Chen-long-bo/-/车轮布局.jpg

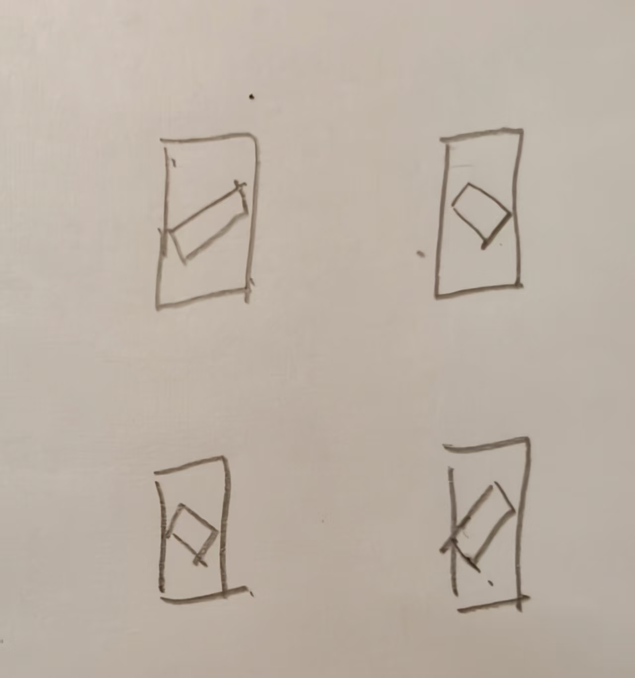
车轮布局.jpg
