Chen-long-bo/-/README.md

# 蓝牙遥控麦轮小车

第一版小车底盘。

## 文档导航

- [教学手册](教学手册.md) —— 从零理解系统、协议、算法、参数和标定流程
- [Keil 使用导航](Keil使用导航.md) —— 打开工程、编译、烧录、调试
- [参数手册](参数手册.md) —— 每个参数的作用、范围、测法和调错现象
- [代码地图](代码地图.md) —— 每个文件所在层、作用、必要性和关键函数
- [工程只读分析报告](工程只读分析报告.md) —— 数据流、参数清单、待确认项、最小改动清单
- [接线图说明](01_接线图.md) / [引脚分配表](02_引脚分配表.md) / [通信协议](03_通信协议_v0.1.md)
- [可视化网站](visualization/index.html) —— 手机适配的离线教学台、标定向导、运动学和 PID 实验
- [分享文件](分享文件/使用说明.txt) —— 单文件网站、单文件手册和完整离线分享包
- [本次修改说明（2026-10-21）](本次修改说明_2026-10-21.md) —— 按键遥控、PID 分离、参数页、缓起缓停删除和烧录结果
- [改造方案与阶段进度](改造方案大纲_v1.md)

## 目录

- `STM32_Project/`：STM32 主固件工程
- `Test_Project/`：编码器、单轮、CPR、旋转、PID 等测试工程
- `PC_上位机/`：PySide6 上位机
- `diagrams/`：系统架构、数据流、麦轮、协议、PID 等 SVG 示意图
