Chen-long-bo/-/03_通信协议_v0.1.md

# 03 蓝牙通信协议 v0.2（PC ↔ STM32）

> 本协议用于 PC 上位机 ↔ HC-04（经典蓝牙 SPP）↔ STM32。
> 2026-10-21 起：普通控制不使用 PID，缓起/缓停/加速度平滑指令已删除；PID 只用于控制与测试页的位置控制。

## 1. 帧格式（小端 little-endian）

```text
[SOF 0xAA][SOF 0x55][LEN][CMD][DATA...][CHECK]
```

| 字段 | 字节数 | 说明 |
|---|---:|---|
| SOF | 2 | 固定 `AA 55` |
| LEN | 1 | `CMD + DATA` 的总字节数，最小 1 |
| CMD | 1 | 指令码 |
| DATA | LEN-1 | 参数数据 |
| CHECK | 1 | `(LEN + CMD + 所有DATA) & 0xFF` |

示例：心跳

```text
AA 55 01 0A 0B
```

LEN=0x01，CHECK=0x01+0x0A=0x0B。

## 2. PC → STM32 指令

| CMD | 名称 | DATA | 说明 |
|---|---|---|---|
| 0x01 | 手动全向速度 | vx(int16) vy(int16) wz(int16) | 单位 0.001 m/s、0.001 rad/s；普通手动页使用，不使用 PID |
| 0x02 | 急刹停 | 无 | 立即发零速度 |
| 0x04 | PID 位置控制 | target(int16) | 目标相对距离，单位 mm；只有控制与测试页使用 |
| 0x05 | 固定路线 | route_id(uint8) side(uint8) | 当前为固件路线占位接口，PC 路线也可在 PC 端执行 |
| 0x06 | 急停 | 无 | 立即停车并清目标 |
| 0x07 | 预留速度环 PID | 无 | 速度环在驱动模块内部，当前不使用 |
| 0x08 | 设置位置 PID | Kp(uint16) Ki(uint16) Kd(uint16) | 参数×1000，只影响位置控制 |
| 0x09 | 清编码器零点 | 无 | 记录当前累计计数为零点 |
| 0x0A | 心跳 | 无 | STM32 回复 ACK 0x83 |
| 0x0B | 读取参数 | 无 | 回复参数帧 0x85 |
| 0x0C | 设置限幅 | vmax(uint16) wmax(uint16) | 单位 0.001 m/s、0.001 rad/s |
| 0x0D | 原地旋转 | angle(int16) | 单位 0.1°；正数左转，负数右转；时间控制，不使用 PID |
| 0x20~0x2F | 自动驾驶预留 | 后续定义 | 预留 |
| 0x30~0x3F | 避障预留 | 后续定义 | 预留 |
| 0x40~0x4F | 视觉预留 | 后续定义 | 预留 |

> 0x03（缓停）和 0x0E（设置加速度）已在 2026-10-21 版本删除。

## 3. STM32 → PC 回报

| CMD | 名称 | DATA | 说明 |
|---|---|---|---|
| 0x81 | 状态帧 | mode(uint8) battery_mV(uint16) enc1..4(int32×4) speed1..4(int16×4) | mode：0空闲/1手动/3PID位置控制/4路线/5旋转；速度单位0.001 m/s |
| 0x82 | 曲线帧 | target1..4(int16×4) actual1..4(int16×4) | 四轮目标/实际速度 |
| 0x83 | ACK | ack_cmd(uint8) err(uint8) | 指令确认 |
| 0x84 | 日志 | ASCII | 调试文本 |
| 0x85 | 参数帧 | pos_Kp/Ki/Kd(uint16×3) + 预留6字节 + vmax(uint16) wmax(uint16) | 当前参数回读 |

## 4. 位置/误差计算

控制与测试页：

```text
平均计数 = 四轮相对起点计数的平均值
实际位置 = 平均计数 / CPR × π × 轮径
位置误差 = 目标位置 - 实际位置
```

PC 端可以用 0x81 状态帧中的四轮累计计数直接计算实际位置和误差，不需要额外协议。

## 5. 版本规则

- 本文件版本 `v0.2`；
- 修改协议时必须同步更新 `PC_上位机/protocol.py`、`PC_上位机/config.py` 和 STM32 `bsp_bluetooth.c`；
- 新增功能优先使用预留指令段，不破坏已有指令。
