Chen-long-bo/-/代码地图.md

> **2026-10-21 变更提示**：当前版本已删除普通控制中的缓起/缓停和加速度平滑；PID 仅保留在控制与测试页。本文部分“平滑/ramp”描述属于历史版本，以实际源码和 `本次修改说明_2026-10-21.md` 为准。

# 麦轮小车 — 代码地图（文件作用 / 必要性 / 技术 / 关键函数）

> 目标：让你知道“每个文件为什么存在、删掉会怎样、用了什么技术、关键函数在哪”。
> 配套图：`diagrams/system_architecture.svg`、`diagrams/data_flow.svg`、`diagrams/mindmap.svg`。

---

## 1. 怎么读这张地图

工程分 4 层：

```text
PC 上位机（PySide6）
  ↓ 蓝牙/串口协议
STM32 应用层（control_mode / route）
  ↓
STM32 算法层（chassis_control / pid / bsp_encoder）
  ↓
STM32 设备层（bsp_motor / bsp_bluetooth / driver_comm）
  ↓
驱动模块 / 电机 / 编码器
```

每个文件下面会写：

- **所在层**；
- **作用**；
- **必要性**（删掉会怎样）；
- **采用技术**；
- **关键函数**；
- **被谁调用 / 调用谁**。

---

## 2. 主固件用户层（`STM32_Project\User`）

| 文件 | 所在层 | 作用 | 必要性 | 采用技术 | 关键函数 |
|---|---|---|---|---|---|
| `config.h` | 配置层 | 所有可调参数集中入口 | 删掉后所有模块找不到参数 | C 宏定义 | `CFG_*` |
| `user_app.c` | 应用入口层 | 初始化模块、启动串口接收、主循环 | 删掉后没有初始化/主循环 | HAL UART 中断、回调 | `User_Init`、`User_Loop`、`HAL_UART_RxCpltCallback` |
| `user_app.h` | 应用入口层 | 声明入口函数 | 删掉后 main.c 无法调用 | C 头文件 | `User_Init`、`User_Loop` |
| `bsp_bluetooth.c` | 协议层 | AA55 帧解析/发送 | 删掉后 PC 无法控制/看不到遥测 | 状态机、校验和、UART | `Bluetooth_Init`、`Bluetooth_OnRxByte`、`Bluetooth_SendFrame` |
| `bsp_bluetooth.h` | 协议层 | 协议接口声明 | 删掉后编译失败 | C 头文件 | — |
| `control_mode.c` | 控制决策层 | 模式状态机、平滑、位置 PID、定时旋转、遥测 | 删掉后没有控制逻辑 | 状态机、PID、斜坡、协议组帧 | `ControlMode_Init`、`ControlMode_OnCommand`、`ControlMode_Poll`、`ControlMode_RunSpeedLoop` |
| `control_mode.h` | 控制决策层 | 模式枚举/接口 | 删掉后协议层无法调用 | C 枚举 | `ControlMode_t` |
| `chassis_control.c` | 运动学层 | 麦轮正/逆运动学 | 删掉后无法把车体速度变成四轮速度 | 线性代数/几何 | `Chassis_Inverse`、`Chassis_Forward` |
| `chassis_control.h` | 运动学层 | 运动学接口 | 删掉后编译失败 | C 头文件 | — |
| `bsp_motor.c` | 执行器层 | 四轮速度限幅并下发 | 删掉后无法驱动电机 | 限幅、UART 文本协议 | `Motor_Init`、`Motor_SetSpeed`、`Motor_Stop` |
| `bsp_motor.h` | 执行器层 | 电机接口 | 删掉后编译失败 | C 头文件 | — |
| `bsp_encoder.c` | 传感器层 | 计数→速度/距离、零点 | 删掉后没有反馈 | 编码器换算、软件零点 | `Encoder_Init`、`Encoder_GetCounts`、`Encoder_GetWheelSpeeds`、`Encoder_CountsToDistance` |
| `bsp_encoder.h` | 传感器层 | 编码器接口 | 删掉后编译失败 | C 头文件 | — |
| `driver_comm.c` | 驱动通信层 | 发 `$Car`/读编码器/读电压，解析文本回包 | 删掉后 STM32 与驱动模块无法通信 | UART、`sscanf`、字符串格式化 | `DriverComm_SendCar`、`DriverComm_OnRxByte`、`DriverComm_RequestEncoder20ms` |
| `driver_comm.h` | 驱动通信层 | 驱动模块数据结构/接口 | 删掉后编译失败 | C 结构体 | `DriverComm_Data_t` |
| `pid.c` | 算法层 | 位置式 PID | 删掉后位置停无法闭环 | PID 控制 | `PID_Init`、`PID_Compute`、`PID_Reset` |
| `pid.h` | 算法层 | PID 结构体/接口 | 删掉后编译失败 | C 结构体 | `PID_HandleTypeDef` |
| `route.c` | 路线层 | 固件路线接口（当前空实现） | 删掉后协议 0x05 无处理；当前 PC 路线不用它 | 状态机占位 | `Route_Start`、`Route_Poll` |
| `route.h` | 路线层 | 路线接口声明 | 删掉后编译失败 | C 头文件 | — |

---

## 3. 主固件 CubeMX 生成层

| 文件 | 作用 | 必要性 | 技术 | 关键函数 |
|---|---|---|---|---|
| `Core\Src\main.c` | HAL 初始化、168MHz 时钟、串口初始化、调用 `User_Init/User_Loop` | 删掉后程序没有入口 | HAL、RCC/PLL | `main`、`SystemClock_Config` |
| `Core\Src\usart.c` | USART1/2/3 初始化、GPIO、NVIC | 删掉后串口不能用 | HAL UART、GPIO AF | `MX_USART1_UART_Init` 等、`HAL_UART_MspInit` |
| `Core\Src\stm32f4xx_it.c` | USART1/2/3 中断入口 | 删掉后中断不触发 | NVIC、HAL IRQ | `USART1_IRQHandler`、`USART2_IRQHandler`、`USART3_IRQHandler` |
| `Core\Src\stm32f4xx_hal_msp.c` | HAL MSP 钩子 | 删掉后底层初始化缺失 | HAL | `HAL_MspInit` |
| `Core\Src\gpio.c` | GPIO 初始化（当前无额外） | 删掉后 GPIO 初始化缺失 | HAL GPIO | `MX_GPIO_Init` |
| `Core\Src\system_stm32f4xx.c` | CMSIS 系统初始化 | 删掉后系统启动异常 | CMSIS | `SystemInit` |
| `Core\Inc\*.h` | HAL/中断/串口声明 | 删掉后编译失败 | C 头文件 | — |
| `Drivers\` | ST HAL/CMSIS 库 | 删掉后 HAL 函数找不到 | ST 官方库 | — |
| `MDK-ARM\MecanumCar.uvprojx` | Keil 工程 | 删掉后无法编译 | Keil MDK | — |

---

## 4. 测试/调试工程（`Test_Project\MecanumTest`）

| 文件 | 作用 | 必要性 | 技术 | 关键函数 |
|---|---|---|---|---|
| `Test\test_app.c` | COM5 ASCII 命令解析 | 删掉后测试工程没有交互 | 文本协议、状态机 | `Test_Init`、`Test_Loop`、`Test_Parse`、`Test_OnRxByte` |
| `Test\debug_algo.c` | 纯算法：麦轮/CPR/旋转/平滑 | 删掉后标定命令无法计算 | 几何、比例换算 | `DebugAlgo_Mecanum`、`DebugAlgo_SuggestCpr`、`DebugAlgo_SuggestRotateMs`、`DebugAlgo_RampStep` |
| `Test\pid.c` | PID 仿真 | 删掉后 `pidstep` 无法运行 | PID | `PID_Compute` |
| `Test\driver_comm.c` | 驱动模块通信（复用） | 删掉后无法驱动/读编码器 | UART | `DriverComm_SendCar`、`DriverComm_OnRxByte` |
| `Test\chassis_control.c` | 麦轮运动学（复用） | 删掉后 `car` 无法解算 | 运动学 | `Chassis_Inverse` |
| `Test\bsp_encoder.c` | 编码器换算（复用） | 删掉后 `enc` 无法换算 | 编码器 | `Encoder_GetCounts` |
| `Test\config.h` | 测试工程参数 | 删掉后测试工程没有参数 | C 宏 | `CFG_*` |
| `Core\...` | 测试工程 HAL/串口初始化 | 删掉后测试工程无法运行 | HAL | `MX_USART*_UART_Init` |

---

## 5. PC 上位机（`PC_上位机`）

| 文件 | 作用 | 必要性 | 技术 | 关键函数/类 |
|---|---|---|---|---|
| `main.py` | 程序入口 | 删掉后无法启动 | PySide6 | `main` |
| `config.py` | 所有上位机参数 | 删掉后界面/协议找不到配置 | Python 常量 | `MAX_VX`、`PORT_*`、`CMD_*` |
| `protocol.py` | 帧打包/解析、指令构造 | 删掉后无法通信 | 二进制协议、`struct` | `build_frame`、`FrameParser`、`cmd_manual`、`parse_status` |
| `serial_worker.py` | 串口线程 | 删掉后无法收发 | QThread、pyserial | `SerialWorker.run`、`send_frame` |
| `demo_worker.py` | 无硬件演示 | 删掉后演示模式不可用 | QThread、模拟 | `DemoWorker._update` |
| `ui\main_window.py` | 主窗口/交互 | 删掉后没有界面 | PySide6 | `MainWindow._manual_tick`、`_route_*`、`_build_debug_tab` |
| `widgets\joystick.py` | 虚拟摇杆 | 删掉后没有摇杆 | QPainter/鼠标事件 | `Joystick._set_from_pos` |
| `widgets\curve_panel.py` | 实时曲线 | 删掉后没有曲线 | pyqtgraph | `CurvePanel.update_data` |

---

## 6. 核心算法文件详解

### 6.1 `control_mode.c`（控制决策核心）

- **模式**：IDLE、MANUAL、BRAKE_SOFT、POS_STOP、ROTATE_ANGLE、ROUTE；
- **`ControlMode_Poll`**：每 20ms 执行一次；请求编码器/电压；按模式执行；
- **`ControlMode_RunSpeedLoop`**：
  1. `Chassis_Inverse` 把 vx/vy/wz 变成四轮线速度；
  2. 除以 `CFG_MAX_WHEEL_SPEED_M_S` 归一化到 -1~1；
  3. 若最大轮速 < `CFG_MIN_DRIVE`，整体放大到最小驱动；
  4. `Motor_SetSpeed` 发给驱动模块；
  5. `Encoder_GetWheelSpeeds` 读取实际速度用于上报。
- **平滑**：`RampToward` 让目标速度按 `g_accel_v/g_accel_w` 逐步变化；
- **位置停**：`ControlMode_GetDistance` + `PID_Compute` + 速度环；
- **旋转**：时间控制，`CFG_ROTATE_MS_PER_90`；
- **遥测**：`ControlMode_SendStatus`/`SendCurve` 组 0x81/0x82 帧。

### 6.2 `chassis_control.c`（麦轮运动学）

- `Chassis_Inverse`：
  ```text
  A = vx - vy - (a+b)·wz
  B = vx + vy + (a+b)·wz
  C = vx + vy - (a+b)·wz
  D = vx - vy + (a+b)·wz
  ```
- `Chassis_Forward` 是反推，调试用；
- **必要性**：没有它，无法把“车体速度”变成“四个轮子的速度”。

### 6.3 `bsp_encoder.c`（编码器换算）

- `Encoder_SetZero`：记录四轮当前累计计数作为零点；
- `Encoder_GetCounts`：当前累计 - 零点；
- `Encoder_GetWheelSpeeds`：20ms 计数 → 圈数 → 周长 → m/s；
- `Encoder_CountsToDistance`：累计计数 → 米；
- **关键参数**：`CFG_ENCODER_CPR`、`CFG_WHEEL_DIAMETER_MM`。

### 6.4 `driver_comm.c`（驱动模块通信）

- `DriverComm_SendCar`：格式化 `$Car:w1,w2,w3,w4!`；
- `DriverComm_SetMotorType520`：`$MOTOR_4CH_SET:0!`；
- `DriverComm_SetMotorParam`：`$MOTOR_PARAM:8,11,56!`；
- `DriverComm_RequestEncoder20ms/Total`：读编码器；
- `DriverComm_OnRxByte`：按 `!` 结尾解析模块回包；
- **技术**：UART 文本协议、`sscanf`、自定义浮点格式化（避免 `%f`）。

### 6.5 `bsp_bluetooth.c`（PC↔STM32 协议）

- `Bluetooth_OnRxByte`：状态机找 `AA 55` → LEN → CMD → DATA → CHECK；
- 校验和：`LEN+CMD+DATA` 求和低 8 位；
- `Bluetooth_SendFrame`：组帧并发送到 USART1；`CFG_DEBUG_BRIDGE_ENABLE=1` 时同时发 USART3。

### 6.6 `pid.c`（PID）

- 位置式 PID：`P=Kp·e`、`I=Ki·∫e`、`D=Kd·de`；
- 积分限幅/输出限幅；
- **注意**：当前 `D` 项没有除 `dt`，参数单位与采样周期有关；调参时以实际现象为准。

### 6.7 `route.c`（固件路线）

- 当前是空实现，`Route_Poll` 返回 0；
- PC 上位机的固定路线不依赖它；
- 若要“脱机路线”，需要在这里实现状态机（前进/转向/计时）。

### 6.8 `test_app.c` + `debug_algo.c`（调试工程）

- `test_app.c`：ASCII 命令解析，直接调用驱动/算法；
- `debug_algo.c`：纯算法，不碰硬件，方便单独验证；
- 新增命令：`mecanum/geo/cpcal/rot90/rotcal/min/sign/ramp/pidstep/link`。

---

## 7. 调用关系（主链路）

```text
main.c
└─ User_Init()
   ├─ DriverComm_Init()
   ├─ Bluetooth_Init()
   ├─ Chassis_Init()
   ├─ ControlMode_Init()
   ├─ HAL_UART_Receive_IT(huart1/2/3)
   ├─ Motor_Init()
   └─ Encoder_Init()

while(1)
└─ User_Loop()
   └─ ControlMode_Poll()
      ├─ Encoder_Request20ms/Total
      ├─ ControlMode_RunSpeedLoop()
      │  ├─ Chassis_Inverse()
      │  ├─ Motor_SetSpeed()
      │  │  └─ DriverComm_SendCar()
      │  └─ Encoder_GetWheelSpeeds()
      └─ ControlMode_SendStatus/Curve()
         └─ Bluetooth_SendFrame()
```

---

## 8. 采用的技术清单

| 技术 | 用在哪里 | 作用 |
|---|---|---|
| STM32 HAL | Core/Drivers | 串口/GPIO/中断/时钟 |
| UART 中断 + 回调 | `user_app.c` | 实时收字节 |
| 二进制协议 + 校验和 | `bsp_bluetooth.c` / `protocol.py` | PC↔STM32 可靠通信 |
| 文本协议 | `driver_comm.c` | STM32↔驱动模块 |
| 状态机 | `control_mode.c`、`bsp_bluetooth.c` | 模式切换/帧解析 |
| 麦克纳姆轮运动学 | `chassis_control.c` | 全向移动 |
| PID | `pid.c` | 位置闭环 |
| 加速度限制 | `control_mode.c` | 平滑起停 |
| PySide6 | `PC_上位机` | 黑色 UI |
| pyserial | `serial_worker.py` | 串口通信 |
| pyqtgraph | `curve_panel.py` | 实时曲线 |
| QThread | `serial_worker.py` / `demo_worker.py` | 不阻塞 UI |

---

## 9. 删掉某个文件会怎样（快速判断）

| 删掉 | 结果 |
|---|---|
| `config.h` | 全部模块编译失败 |
| `user_app.c` | 没有初始化/主循环 |
| `bsp_bluetooth.c` | PC 无法控制/看不到数据 |
| `control_mode.c` | 没有模式/PID/平滑/遥测 |
| `chassis_control.c` | 无法解算四轮速度 |
| `bsp_motor.c` | 无法驱动电机 |
| `bsp_encoder.c` | 没有速度/距离反馈 |
| `driver_comm.c` | STM32 与驱动模块断开 |
| `pid.c` | 位置停无法闭环 |
| `route.c` | 固件路线 0x05 无效（PC 路线仍可用） |
| `main.c` / `usart.c` | 程序无法启动/串口不可用 |
| `protocol.py` / `serial_worker.py` | 上位机无法通信 |
| `main_window.py` | 上位机没有界面 |
