Chen-long-bo/-/参数手册.md

> **2026-10-21 变更提示**：普通手动、固定路线、旋转已删除缓起/缓停和加速度平滑；`0x03`、`0x0E`、`CFG_ACCEL_*`、`CFG_SOFT_BRAKE_DECEL` 已从当前固件删除。本文中如仍有这些历史条目，仅作为旧版本记录；当前参数以 `上位机参数调节页` 和 `本次修改说明_2026-10-21.md` 为准。

# 麦轮小车 — 参数手册与标定指南

> 配套工程：`D:\CODEX-WORK\蓝牙遥控麦轮小车`
> 目标：让你知道**每个参数调的是什么、为什么调、怎么测、调错会怎样**。
> 本手册只讲参数与标定，不替代教学手册的原理部分。

---

## 1. 先分清三类参数

| 类型 | 在哪里 | 改完要做什么 | 例子 |
|---|---|---|---|
| **编译期参数** | `STM32_Project\User\config.h`、`Test_Project\MecanumTest\Test\config.h` | 重新编译 + 烧录 | CPR、轮径、轴距、最小驱动、加速度、旋转时间 |
| **运行期参数** | 上位机“PID调参”“调试中心” | 点“下发”即可，掉电不保存 | 位置 PID、限幅、加速度（0x0E） |
| **只读/诊断** | 上位机状态栏、日志、`enc` 命令 | 不需要改 | 电池电压、编码器计数、模式 |

> 重要：`config.h` 里的 `CFG_DRIVER_BAUD`、`CFG_DEBUG_BAUD` 目前**没有**被 `usart.c` 引用；USART2/USART3 实际硬编码 115200。只改这两个宏不会改变串口波特率。

---

## 2. 参数总表

### 2.1 通信参数

| 参数 | 当前值/单位 | 合理范围 | 影响什么 | 怎么测/怎么定 | 调错会怎样 |
|---|---:|---|---|---|---|
| `CFG_BLUETOOTH_BAUD` | 9600 bps | 9600 / 38400 / 115200 | STM32 USART1 与 HC-04 的波特率 | 用 USB-TTL 给 HC-04 发 `AT+BAUD=?` 查询；或看模块资料 | 蓝牙完全无数据、乱码 |
| `CFG_DRIVER_BAUD` | 115200 bps | 115200（按模块） | 注释上表示驱动模块波特率 | 目前 `usart.c` 硬编码 115200，改此宏无效 | 改错也不会生效，容易误判 |
| `CFG_DEBUG_BAUD` | 115200 bps | 115200 | 注释上表示调试串口波特率 | 目前 `usart.c` 硬编码 115200，改此宏无效 | 同上 |
| 上位机端口 | COM7 | COM7/COM8/COM5 | 连接哪个串口 | 设备管理器/蓝牙设置里看“传出”端口 | 连错口 → 无数据 |
| 上位机波特率 | 9600 | 9600/115200 | 与 HC-04 匹配 | 与 `CFG_BLUETOOTH_BAUD` 保持一致 | 无数据/乱码 |
| 协议缩放（手动） | ×1000 | 固定 | vx/vy/wz 的 int16 单位 | 两端必须一致 | 速度被放大/缩小 1000 倍 |
| 协议缩放（旋转） | ×10 | 固定 | 角度 0.1° 单位 | 两端必须一致 | 角度差 10 倍 |

### 2.2 机械与几何参数

| 参数 | 当前值/单位 | 合理范围 | 影响什么 | 怎么测/怎么定 | 调错会怎样 |
|---|---:|---|---|---|---|
| `CFG_WHEEL_DIAMETER_MM` | 80.0 mm | 60~100 mm | 轮速/距离换算、`$MOTOR_PARAM` 轮径 | 用卡尺量轮子直径（含胎面） | 距离/速度比例错误 |
| `CFG_WHEELBASE_MM` | 130.0 mm | 按实车 | 麦轮逆运动学半轴距 | 量前轮中心到后轮中心的距离 | 旋转/横移轮速差不正确 |
| `CFG_TRACK_MM` | 123.5 mm | 按实车 | 麦轮逆运动学半轮距 | 量左轮中心到右轮中心的距离 | 旋转/横移轮速差不正确 |
| 轮子安装位置 | A左前/B右前/C左后/D右后 | 固定 | 运动学与方向 | 看实车；和模块手册约定一致 | 前进变斜行、旋转方向错 |
| 辊轮方向 | X 型（假设） | X 或 O | 运动学符号 | 看四个轮子的辊子排列 | 横移/旋转方向反 |
| 单轮方向符号 | +1（默认） | +1/-1 | 该轮实际转向 | 用 `wheel 0 0.3` 单轮点动观察 | 该轮反着转 |

### 2.3 编码器参数

| 参数 | 当前值/单位 | 合理范围 | 影响什么 | 怎么测/怎么定 | 调错会怎样 |
|---|---:|---|---|---|---|
| 编码器线数 PPR | 11 | 按电机 | 每转脉冲数 | 看电机铭牌/卖家资料 | CPR 计算错误 |
| 减速比 | 56 | 按电机 | 输出轴转数换算 | 看电机铭牌/卖家资料 | 速度/距离比例错误 |
| `CFG_ENCODER_CPR` | 2464 counts/rev | 实测为准 | 计数→圈数→速度/距离 | 用测试工程 `enczero` → 走已知距离 → `cpcal <mm>` | 速度/距离/PID 全部比例错 |
| 编码器零点 | 上电/`enczero` | — | 相对计数起点 | 发 `enczero` | 位置停起点漂移 |
| 编码器符号 | +1（默认） | +1/-1 | 速度/距离方向 | 手动转轮看计数正负 | 速度/距离反向 |

### 2.4 运动学与控制参数

| 参数 | 当前值/单位 | 合理范围 | 影响什么 | 怎么测/怎么定 | 调错会怎样 |
|---|---:|---|---|---|---|
| `CFG_MAX_SPEED_M_S` | 1.0 m/s | 0.1~2.0 | 手动 vx/vy 限幅 | 先小后大，观察车能否稳定 | 太大失控，太小很肉 |
| `CFG_MAX_OMEGA_RAD_S` | 1.0 rad/s | 0.1~3.0 | 手动 wz 限幅 | 先小后大 | 旋转过快/打滑 |
| `CFG_MAX_WHEEL_SPEED_M_S` | 1.0 m/s | 实测最大轮速 | 把轮速归一化到 `$Car` 的 -1~1 | 用测试工程测单轮最大平稳速度 | 归一化比例错，速度整体偏大/偏小 |
| `CFG_MIN_DRIVE` | 0.30 | 0.05~0.50 | 低于此值的非零轮速会被整体放大到 0.30 | 用 `min <speed>` 从 0.05 慢慢加，记录“开始平稳”的值 | 太小 → 震动；太大 → 起步猛、低速不可控 |
| `CFG_ACCEL_V` | 1.0 m/s² | 0.1~5.0 | 线速度平滑 | 用 `ramp` 仿真 + 实车起步观察 | 太大 → 急起急停；太小 → 很肉 |
| `CFG_ACCEL_W` | 3.0 rad/s² | 0.5~10.0 | 角速度平滑 | 旋转观察 | 同上 |
| `CFG_ROTATE_DRIVE` | 0.60 | 0.30~1.00 | 定时旋转的轮速 | 先 0.6，观察是否打滑 | 太大 → 过冲；太小 → 转不动 |
| `CFG_ROTATE_MS_PER_90` | 900 ms | 300~3000 ms | 转 90° 的时间 | 用 `rot90` + 实测角度，`rotcal <deg>` 计算 | 转多/转少 |
| `CFG_POS_KP` | 0.8 | 0.05~5.0 | 位置环比例 | PID 调参页/`pidstep` 仿真 | 太大 → 超调；太小 → 到不了位 |
| `CFG_POS_KI` | 0.0 | 0~1.0 | 位置环积分 | 先 0，有静差再加 | 太大 → 积分饱和/超调 |
| `CFG_POS_KD` | 0.0 | 0~1.0 | 位置环微分 | 先 0，超调再加 | 太大 → 抖动/噪声 |
| `POS_STOP_TOL_MM` | 10 mm | 2~20 mm | 位置停到位判定 | 观察停车误差 | 太大 → 停不准；太小 → 来回找 |
| `CFG_SOFT_BRAKE_DECEL` | 0.02 m/s/20ms | 0.005~0.1 | 缓停减速度 | 观察缓停时间 | 太大 → 接近急刹；太小 → 停不住 |
| `CFG_LOOP_MS` | 20 ms | 5~50 ms | 控制周期 | 一般不改 | 太大 → 控制迟钝；太小 → 负担大 |
| `CFG_TELEMETRY_MS` | 100 ms | 20~500 ms | 状态/曲线上报 | 一般不改 | 太小 → 串口拥堵；太大 → 曲线稀疏 |

### 2.5 安全与路线参数

| 参数 | 当前值/单位 | 合理范围 | 影响什么 | 怎么测/怎么定 | 调错会怎样 |
|---|---:|---|---|---|---|
| 急停 | 0x06 | — | 立即停车 | 点“全停”/空格 | 不停 → 检查链路/电源 |
| 缓停 | 0x03 | — | 平滑减速 | 点“缓停” | 减速太快/太慢 → 调 `CFG_SOFT_BRAKE_DECEL` |
| 路线边长 | 800 mm | 100~1000 mm | 正方形边长 | 界面输入 | 太大超 1m 范围 |
| 路线速度 | 0.40 m/s | 0.30~1.00 m/s | 前进速度 | 先 0.3~0.4 | 太快路线变形 |
| 路线停顿 | 500 ms | 0~3000 ms | 每段停顿 | 观察车是否稳定 | 0 → 连续动作；太大 → 很慢 |
| 路线转向等待 | 1200 ms | 按固件 90° 时间 | 等待转向完成 | 与 `CFG_ROTATE_MS_PER_90` 匹配 | 太短 → 没转完就走 |

### 2.6 调试参数/命令

| 调试项 | 命令/界面 | 作用 | 关键观察 |
|---|---|---|---|
| 链路测试 | 上位机“测试链路” / `link` | 确认收发 | 心跳 ACK / `link ok` |
| 原始计数 | `enc` / `encraw` | 看编码器 | 四轮计数是否变化 |
| CPR 标定 | `enczero` → 走已知距离 → `cpcal <mm>` | 反算 CPR | 建议 CPR 是否接近 2464 |
| 旋转标定 | `rot90` → 量角度 → `rotcal <deg>` | 反算 90° 时间 | 建议 ms |
| 最小驱动 | `min <speed>` | 找震动/平稳阈值 | 哪个速度开始平稳 |
| 单轮方向 | `wheel <0-3> <speed>` / `sign` | 看方向/设符号 | 方向是否符合 A/B/C/D |
| 几何预览 | `mecanum` / `geo` | 只算不驱动 | 四轮速度是否合理 |
| 加速度 | `ramp` / 上位机平滑 | 看平滑时间线 | 速度是否渐进 |
| PID 仿真 | `pidstep` / PID 调参页 | 看阶跃响应 | 超调/上升时间 |

---

## 3. 标定步骤（按顺序做）

### 3.1 蓝牙链路（先保证有数据）

1. 只接 HC-04 四根线：`3V3→3V3`、`GND→GND`、`RXD→PA9`、`TXD→PA10`；KEY 悬空。
2. 开发板上电，HC-04 LED 常亮（已连接）。
3. 上位机选 **COM7**、**9600**，点“连接”。
4. 看左侧连接状态：
   - “已连接（数据正常）”且 RX 字节增长 → 链路正常；
   - “已连接（无数据）” → 检查接线/波特率/AT 模式。
5. 点“测试链路”，日志出现“链路测试成功：收到心跳ACK” → OK。

### 3.2 编码器方向与符号

1. 测试工程发 `enczero`。
2. 发 `wheel 0 0.3`（A 轮正转），看 `enc` 的 A 轮计数：
   - 计数增加 → A 轮符号 +1；
   - 计数减少或为 0 → 检查接线/极性，必要时 `sign 0 -1`。
3. 对 B/C/D 重复。
4. 记录四轮符号表。

### 3.3 编码器 CPR 标定

1. `enczero` 清零。
2. 让车**直线前进一段已知距离**（建议 ≥1m，用尺量）。
3. 发 `enc`，记下四轮累计计数。
4. 发 `cpcal 1000`（假设走了 1000mm）。
5. 看“建议 CPR”：
   - 若建议值接近 2464 → 理论值正确；
   - 若差很多 → 把 `CFG_ENCODER_CPR` 改成建议值（两处：主工程 `User\config.h`、测试工程 `Test\config.h`）。
6. 重新编译烧录，再走一次 1m，确认状态/曲线距离接近 1m。

> 注意：`cpcal` 用的是“当前相对计数”，所以一定要先 `enczero`，再走距离。

### 3.4 轮径/轴距/轮距

| 量什么 | 怎么量 | 写到哪里 |
|---|---|---|
| 轮径 | 卡尺量轮子外径（含胎面） | `CFG_WHEEL_DIAMETER_MM` |
| 轴距 | 前轮中心到后轮中心 | `CFG_WHEELBASE_MM` |
| 轮距 | 左轮中心到右轮中心 | `CFG_TRACK_MM` |

> 不要量外缘到外缘；要量**轮子中心**之间的距离。

### 3.5 最小驱动（震动阈值）

1. 测试工程发 `min 0.05`，观察轮子是否震动/乱转。
2. 逐步 `min 0.10`、`min 0.15`……直到轮子**平稳连续转动**。
3. 记录“开始平稳”的速度值。
4. 把 `CFG_MIN_DRIVE` 设为该值附近（建议略高一点，如 0.30）。
5. 重新测试：手动小摇杆时，轮子应直接进入平稳转动，而不是震动。

### 3.6 加速度平滑

1. 测试工程发 `ramp 0 0.5 1.0`，看速度时间线。
2. 实车手动推杆，观察起步/停止是否平缓。
3. 太急 → 减小 `CFG_ACCEL_V`（如 0.5）；太肉 → 增大（如 2.0）。
4. 角加速度同理调 `CFG_ACCEL_W`。

### 3.7 原地旋转 90°

1. 测试工程发 `rot90 0.6 900`（左转）。
2. 用量角器/手机水平仪/地砖线量实际转过的角度。
3. 发 `rotcal <实测角度>`，得到建议 90° 时间。
4. 把 `CFG_ROTATE_MS_PER_90` 改成建议值。
5. 重新烧录，再测 45°/90°，直到误差可接受。
6. 若方向反了：`rot90 -0.6 900` 试右转；或在固件里交换左右轮符号。

### 3.8 位置环 PID

1. 先用 `pidstep 0.8 0 0 100` 看仿真：位置是否到达、是否超调。
2. 实车用上位机“PID调参”页：
   - 先 `Ki=0, Kd=0`，只加 `Kp`，直到能走到目标但略有超调；
   - 再加一点 `Ki` 消除静差；
   - 超调明显时加一点 `Kd`。
3. 每次只改一个参数，记录现象。
4. 位置停的“到位容差”是 `POS_STOP_TOL_MM=10mm`，想更准可减小，但可能来回找。

### 3.9 固定路线

1. 界面设边长 600~800mm、速度 0.4、停顿 500ms。
2. 点“开始”，观察：
   - 是否按“前进→停顿→左转→停顿”执行；
   - 进度是否正常推进（不应瞬间跳到第3条边）。
3. 若走过头/走不够：
   - 走不够 → 提高路线速度或增加前进时间；
   - 走过头 → 降低速度或减少时间。
4. 当前路线是**时间控制**，不是编码器闭环；精度取决于速度/地面/电池。

---

## 4. 测试工程命令表

烧录 `Test_Project\MecanumTest` 后，用 COM5（115200）发命令：

| 命令 | 例子 | 作用 | 观察什么 |
|---|---|---|---|
| `help` | `help` | 显示帮助 | 命令列表 |
| `stop` | `stop` | 停车 | 四轮停 |
| `bat` | `bat` | 读电压 | `battery_raw` |
| `enc` | `enc` | 读编码器 | 20ms/累计计数 |
| `enczero` | `enczero` | 编码器清零 | 相对计数归零 |
| `car` | `car 0.3 0 0` | 整车前进 | 四轮转动 |
| `wheel` | `wheel 0 0.3` | 单轮点动 | A 轮方向/计数 |
| `mecanum` | `mecanum 0.3 0 0` | 只算四轮目标 | 不驱动，打印四轮 m/s |
| `geo` | `geo 0.3 0 0 130 123.5` | 自定义几何预览 | 四轮 m/s |
| `cpcal` | `cpcal 1000` | 由计数反算 CPR | 建议 CPR |
| `rot90` | `rot90 0.6 900` | 左转 90° 脉冲 | 实际角度 |
| `rotcal` | `rotcal 85` | 由实测角度反算时间 | 建议 ms |
| `min` | `min 0.3` | 低速脉冲 1.5s | 震动/平稳 |
| `sign` | `sign 0 -1` | 设置 A 轮符号 | 四轮符号表 |
| `ramp` | `ramp 0 0.5 1.0` | 加速度时间线 | 速度渐进 |
| `pidstep` | `pidstep 0.8 0 0 100` | PID 阶跃仿真 | 位置/输出曲线 |
| `raw` | `raw $Car:0.3,0.3,0.3,0.3!` | 直发模块文本 | 模块响应 |
| `link` | `link` | 链路自检 | `link ok` |

---

## 5. 上位机“调试中心”使用说明

| 卡片 | 怎么用 | 得到什么 |
|---|---|---|
| 链路状态 | 点“测试链路”/“发送心跳” | 是否有 ACK、RX 字节 |
| 原始帧发送 | 输入 `AA 55 ...` 十六进制，点发送 | 直接测试协议 |
| 编码器 CPR | 记录起点 → 走距离 → 记录终点并计算 | 建议 CPR |
| 原地旋转时间 | 发送 90° → 量角度 → 计算建议时间 | 建议 `CFG_ROTATE_MS_PER_90` |
| 运动点动 | 前进/后退/左移/右移/左转/右转 | 看方向、是否震动 |
| 麦轮几何预览 | 输入 vx/vy/wz → 计算 | 四轮目标速度 |
| 加速度平滑 | 输入线/角加速度 → 下发 | 起步/停止更平滑 |
| 参数总览 | 只读 | 当前关键参数 |

---

## 6. 标定记录表（建议打印/复制填写）

### 6.1 机械与编码器

| 项目 | 实测值 | 单位 | 备注 |
|---|---:|---|---|
| 轮径 |  | mm | 卡尺 |
| 轴距 |  | mm | 前后轮中心 |
| 轮距 |  | mm | 左右轮中心 |
| 编码器线数 |  | PPR | 铭牌 |
| 减速比 |  | :1 | 铭牌 |
| 1m 行走计数（A/B/C/D） |  | counts | `enc` |
| 建议 CPR |  | counts/rev | `cpcal 1000` |

### 6.2 方向与最小驱动

| 轮子 | 正转方向是否正确 | 符号 | 开始平稳的最小速度 |
|---|---|---|---|
| A 左前 |  | +1/-1 |  |
| B 右前 |  | +1/-1 |  |
| C 左后 |  | +1/-1 |  |
| D 右后 |  | +1/-1 |  |

### 6.3 旋转与 PID

| 项目 | 值 | 备注 |
|---|---:|---|
| 当前 90° 时间 | 900 ms | `CFG_ROTATE_MS_PER_90` |
| 实测 90° 角度 |  | 度量 |
| 建议 90° 时间 |  | `rotcal` |
| PID Kp/Ki/Kd | 0.8 / 0 / 0 | 记录每次修改 |
| 位置停误差 |  | mm |
| 缓停时间 |  | s |

---

## 7. 常见问题

| 现象 | 优先检查 | 可能原因 |
|---|---|---|
| 蓝牙连接但无数据 | 接线/波特率/AT模式/COM口 | HC-04 TX/RX 反、未共地、波特率不对、KEY 被拉 |
| 电机不转 | 驱动电源/`$Car`/最小驱动 | 12V 没接、模块未使能、速度低于阈值 |
| 轮子震动 | 最小驱动 | `CFG_MIN_DRIVE` 太小 |
| 编码器为 0 | 编码器线/供电/极性 | A/B 未接、Vcc/GND 错、模块未读 |
| 前进斜行 | 轮子方向/几何 | 单轮符号错、轴距/轮距错、辊轮方向错 |
| 旋转角度不准 | 旋转时间 | `CFG_ROTATE_MS_PER_90` 未标定、地面打滑 |
| 路线瞬间跳边 | 定时器/旧回调 | 重复点开始、旧定时器未作废（已加 `route_gen`） |
| PID 停超调 | Kp/Ki/Kd | Kp 太大、Ki 饱和、Kd 噪声 |
