Chen-long-bo/-/工程只读分析报告.md

> **2026-10-21 变更提示**：普通控制中的缓起/缓停/加速度平滑已删除，PID 仅在控制与测试页使用；本报告是历史只读分析，当前参数以 `PC_上位机/parameter_guide.json` 和 `本次修改说明_2026-10-21.md` 为准。

# 蓝牙遥控麦轮小车 — 当前工程只读分析报告

> 根目录：`D:\CODEX-WORK\蓝牙遥控麦轮小车`
> 说明：本报告基于当前工作区源码只读分析。除本 Markdown 文件外，没有修改任何源文件、没有重新编译、没有烧录。

## 0. 结论摘要

当前工程分成三条独立链路：

1. **主控制链路**：PC 上位机 → 经典蓝牙 SPP（当前默认 COM7）或 COM5 有线调试 → STM32F407 → USART2 → 松甲四路编码器电机驱动模块 → 四个电机；
2. **反馈链路**：四个编码器 → 驱动模块 → USART2 → STM32 → 蓝牙/有线 → PC 上位机；
3. **测试链路**：PC COM5 文本命令 → 独立测试工程 `MecanumTest` → 驱动模块 → 电机/编码器。

关键事实：

- 速度环**不在 STM32**，而在松甲驱动模块内部（`$Car` 闭环转速）；
- STM32 负责：协议解析、麦轮运动学、目标速度平滑、位置环 PID、定时原地旋转、遥测上报；
- 固定路线目前由**上位机**按“前进 → 停顿 → 左转90° → 停顿”执行，固件里的 `route.c` 仍是空实现；
- 主固件当前默认蓝牙 9600，驱动模块 115200，调试串口 115200；
- 工程里存在一个**重复/过期的 `User\User` 目录**，Keil 实际引用的是 `MecanumCar\User`。

---

## 1. 源文件/目录清单（按控制层级）

### 1.1 主固件用户层

| 文件 | 所在层 | 一句话说明 |
|---|---|---|
| `STM32_Project\User\config.h` | 配置层 | 所有主固件可调参数的集中入口。 |
| `STM32_Project\User\user_app.c` | 应用入口层 | 初始化各模块、启动三个串口接收、把主循环交给 `ControlMode_Poll()`。 |
| `STM32_Project\User\user_app.h` | 应用入口层 | 声明 `User_Init()` 和 `User_Loop()`。 |
| `STM32_Project\User\bsp_bluetooth.c` | 通信协议层 | 解析 PC 下发的 AA55 二进制帧，并把回报帧发回蓝牙/调试串口。 |
| `STM32_Project\User\bsp_bluetooth.h` | 通信协议层 | 声明蓝牙协议初始化、收字节、发帧接口。 |
| `STM32_Project\User\control_mode.c` | 控制决策层 | 模式状态机、速度平滑、位置环、定时旋转、遥测组帧。 |
| `STM32_Project\User\control_mode.h` | 控制决策层 | 定义运行模式枚举和控制模式接口。 |
| `STM32_Project\User\chassis_control.c` | 运动学层 | 麦克纳姆轮正/逆运动学，把车体速度换算成四轮线速度。 |
| `STM32_Project\User\chassis_control.h` | 运动学层 | 声明底盘运动学接口。 |
| `STM32_Project\User\bsp_motor.c` | 执行器抽象层 | 把四轮归一化速度限幅后交给驱动模块（`$Car`）。 |
| `STM32_Project\User\bsp_motor.h` | 执行器抽象层 | 声明电机初始化、设速度、停车接口。 |
| `STM32_Project\User\bsp_encoder.c` | 传感器抽象层 | 把驱动模块回传的编码器计数换算成速度/距离，并维护软件零点。 |
| `STM32_Project\User\bsp_encoder.h` | 传感器抽象层 | 声明编码器读取与换算接口。 |
| `STM32_Project\User\driver_comm.c` | 驱动模块通信层 | 向驱动模块发 `$Car`/读编码器/读电压，并解析文本回包。 |
| `STM32_Project\User\driver_comm.h` | 驱动模块通信层 | 定义驱动模块数据结构和通信接口。 |
| `STM32_Project\User\pid.c` | 算法层 | 通用位置式 PID 计算。 |
| `STM32_Project\User\pid.h` | 算法层 | 定义 PID 结构体和接口。 |
| `STM32_Project\User\route.c` | 路线层 | 固定路线接口；当前仍是空实现（输出 0 速度）。 |
| `STM32_Project\User\route.h` | 路线层 | 声明路线启动和轮询接口。 |

### 1.2 主固件 CubeMX 生成/初始化层

| 文件 | 所在层 | 一句话说明 |
|---|---|---|
| `STM32_Project\CubeMX\MecanumCar\Core\Src\main.c` | 启动层 | HAL 初始化、168MHz 时钟、三个串口初始化，并调用 `User_Init()`/`User_Loop()`。 |
| `STM32_Project\CubeMX\MecanumCar\Core\Src\usart.c` | 外设初始化层 | 配置 USART1/2/3 的波特率、PA9/PA10、PA2/PA3、PB10/PB11 和 NVIC 中断。 |
| `STM32_Project\CubeMX\MecanumCar\Core\Src\stm32f4xx_it.c` | 中断层 | 提供 USART1/2/3 的 IRQHandler，调用 HAL 的 UART 中断处理。 |
| `STM32_Project\CubeMX\MecanumCar\Core\Src\stm32f4xx_hal_msp.c` | HAL 底层初始化层 | HAL 的 MSP 初始化钩子。 |
| `STM32_Project\CubeMX\MecanumCar\Core\Src\gpio.c` | GPIO 层 | 当前没有额外用户 GPIO 配置。 |
| `STM32_Project\CubeMX\MecanumCar\Core\Src\system_stm32f4xx.c` | CMSIS 系统层 | STM32F4 系统初始化。 |
| `STM32_Project\CubeMX\MecanumCar\Core\Inc\main.h` | 头文件层 | HAL 头文件和全局声明入口。 |
| `STM32_Project\CubeMX\MecanumCar\Core\Inc\usart.h` | 头文件层 | 声明 `huart1/2/3` 和串口初始化函数。 |
| `STM32_Project\CubeMX\MecanumCar\Core\Inc\stm32f4xx_it.h` | 头文件层 | 声明各中断处理函数。 |
| `STM32_Project\CubeMX\MecanumCar\Core\Inc\stm32f4xx_hal_conf.h` | HAL 配置层 | HAL 模块开关和时钟值配置。 |
| `STM32_Project\CubeMX\MecanumCar\MecanumCar.ioc` | CubeMX 配置层 | CubeMX 工程配置（时钟、串口、中断、工程路径）。 |
| `STM32_Project\CubeMX\MecanumCar\MDK-ARM\MecanumCar.uvprojx` | 构建层 | Keil 工程文件，决定源文件、包含路径、编译器版本。 |
| `STM32_Project\CubeMX\MecanumCar\Drivers\` | 第三方库层 | STM32F4 HAL/CMSIS 驱动库，不逐个列出。 |
| `STM32_Project\CubeMX\MecanumCar\MDK-ARM\MecanumCar\` | 构建产物层 | `.axf/.hex/.map/.o` 等编译输出。 |

### 1.3 独立测试工程

| 文件 | 所在层 | 一句话说明 |
|---|---|---|
| `Test_Project\MecanumTest\Test\test_app.c` | 测试应用层 | COM5 ASCII 命令解析：`help/stop/bat/enc/enczero/car/wheel/raw`。 |
| `Test_Project\MecanumTest\Test\test_app.h` | 测试应用层 | 声明 `Test_Init()`/`Test_Loop()`。 |
| `Test_Project\MecanumTest\Test\config.h` | 测试配置层 | 测试工程自己的轮径、轴距、轮距、CPR、归一化基准。 |
| `Test_Project\MecanumTest\Test\driver_comm.c` | 测试通信层 | 测试工程复用的驱动模块串口通信/解析。 |
| `Test_Project\MecanumTest\Test\driver_comm.h` | 测试通信层 | 测试工程驱动模块接口。 |
| `Test_Project\MecanumTest\Test\chassis_control.c` | 测试运动学层 | 测试工程复用的麦轮逆运动学。 |
| `Test_Project\MecanumTest\Test\chassis_control.h` | 测试运动学层 | 测试工程运动学接口。 |
| `Test_Project\MecanumTest\Test\bsp_encoder.c` | 测试传感器层 | 测试工程复用的编码器换算。 |
| `Test_Project\MecanumTest\Test\bsp_encoder.h` | 测试传感器层 | 测试工程编码器接口。 |
| `Test_Project\MecanumTest\Core\Src\main.c` | 测试启动层 | 初始化 HAL/串口，调用 `Test_Init()`/`Test_Loop()`。 |
| `Test_Project\MecanumTest\Core\Src\usart.c` | 测试外设层 | 配置 USART1/2/3；测试工程实际用 USART2（驱动）和 USART3（COM5）。 |
| `Test_Project\MecanumTest\Core\Src\stm32f4xx_it.c` | 测试中断层 | USART2/3 等中断处理。 |
| `Test_Project\MecanumTest\MDK-ARM\MecanumTest.uvprojx` | 测试构建层 | 测试工程 Keil 工程文件。 |
| `Test_Project\MecanumTest\Drivers\` | 测试第三方库层 | 测试工程的 ST HAL/CMSIS。 |
| `Test_Project\MecanumTest\MDK-ARM\MecanumTest\` | 测试构建产物层 | 测试工程 `.axf/.hex/.map` 等。 |

### 1.4 PC 上位机

| 文件 | 所在层 | 一句话说明 |
|---|---|---|
| `PC_上位机\main.py` | 程序入口层 | 创建 QApplication、主窗口并进入 Qt 事件循环。 |
| `PC_上位机\config.py` | 上位机配置层 | 串口、车体尺寸、限幅、协议码、颜色、默认 PID/路线参数。 |
| `PC_上位机\protocol.py` | 协议层 | 帧打包/解析、指令构造、状态/曲线/ACK/参数解析。 |
| `PC_上位机\serial_worker.py` | 传输层 | 串口线程：打开端口、收发字节、解析帧、发出 Qt 信号。 |
| `PC_上位机\demo_worker.py` | 演示/模拟层 | 无硬件时模拟小车状态、曲线和指令响应。 |
| `PC_上位机\ui\main_window.py` | 表示/交互层 | 主窗口、连接、手动遥控、路线、PID、曲线、日志、预留 Tab。 |
| `PC_上位机\widgets\joystick.py` | 控件层 | 圆形虚拟摇杆，输出 -1~1 的 x/y。 |
| `PC_上位机\widgets\curve_panel.py` | 控件层 | pyqtgraph 四轮目标/实际速度实时曲线。 |
| `PC_上位机\requirements.txt` | 依赖层 | PySide6/pyserial/bleak/pyqtgraph 依赖。 |
| `PC_上位机\README.md` | 文档层 | 安装、运行、操作说明。 |

### 1.5 文档与辅助文件

| 文件 | 所在层 | 说明 |
|---|---|---|
| `00_需求与条件核对.md` | 需求层 | 需求、硬件条件、进度记录。 |
| `01_接线图.md` | 硬件层 | 供电、STM32/驱动/蓝牙/USB-TTL/SWD 接线表。 |
| `02_引脚分配表.md` | 硬件层 | STM32 引脚与外设分配。 |
| `03_通信协议_v0.1.md` | 协议层 | PC↔STM32 协议说明。 |
| `接线图.svg` | 硬件层 | 接线总览图。 |
| `STM32_Project\README.md` | 主工程文档 | 主工程结构说明。 |
| `STM32_Project\CubeMX配置说明.md` | 主工程文档 | CubeMX 配置与 Keil 集成步骤。 |
| `STM32_Project\已生成工程说明.md` | 主工程文档 | 已生成/编译/烧录状态说明。 |
| `Test_Project\README.md` | 测试工程文档 | 测试命令和当前测试结论。 |
| `PC_上位机\_*.py` | 临时诊断脚本 | 串口/蓝牙/UI 的临时测试脚本，不属于上位机运行链路。 |
| `_check_braces.py`、`_test_ports.py` 等 | 临时脚本 | 早期排查用的临时脚本，不属于工程运行链路。 |

### 1.6 目录级注意事项

1. `STM32_Project\CubeMX\MecanumCar\User\` 是 Keil 实际引用的用户代码目录（`../User/*.c`）。
2. `STM32_Project\CubeMX\MecanumCar\User\User\` 是**重复/过期副本**（其中 `control_mode.c` 只有 9612 字节，而实际使用的是 13889 字节版本），当前 Keil 工程不引用它，但容易造成误改。
3. `Drivers\` 是 ST 官方 HAL/CMSIS 库，属于第三方底层，不建议逐文件修改。
4. `MDK-ARM\MecanumCar\`、`MDK-ARM\MecanumTest\` 是构建产物（`.o/.axf/.hex/.map`），不是源代码。

---

## 2. 完整数据流：从“上位机/蓝牙指令”到“四个轮子转动”

### 2.1 主链路：PC → 蓝牙 → STM32 → 驱动模块 → 电机

| 步骤 | 层级 | 文件 | 函数/位置 | 发生什么 |
|---|---|---|---|---|
| 1 | PC 交互层 | `PC_上位机\ui\main_window.py` | `MainWindow._manual_tick()` | 每 50ms 读取摇杆 `joy_x/joy_y`、键盘 `keys`、旋转标志，计算 vx/vy/wz。 |
| 2 | PC 交互层 | `PC_上位机\ui\main_window.py` | `MainWindow._rotate_angle()` / `_special_send()` | 旋转、急刹、缓停、全停等按钮直接调用对应协议帧。 |
| 3 | PC 协议层 | `PC_上位机\protocol.py` | `cmd_manual()` | 把 vx/vy/wz 乘 1000 后打包成 3 个 int16。 |
| 4 | PC 协议层 | `PC_上位机\protocol.py` | `build_frame()` | 加上 `AA 55 LEN CMD DATA CHECK`，校验和 = LEN+CMD+DATA 之和低 8 位。 |
| 5 | PC 传输层 | `PC_上位机\serial_worker.py` | `SerialWorker.send_frame()` | 把整帧写入 COM7（蓝牙 SPP）或 COM5（有线）。 |
| 6 | 蓝牙/硬件层 | HC-04（工程外） | 透明传输 | HC-04 把串口字节透传给 STM32 USART1。 |
| 7 | STM32 外设层 | `STM32_Project\CubeMX\MecanumCar\Core\Src\usart.c` | `MX_USART1_UART_Init()` / `HAL_UART_MspInit()` | USART1 配置为 PA9/PA10、9600、8N1，并使能 USART1 中断。 |
| 8 | STM32 中断层 | `STM32_Project\CubeMX\MecanumCar\Core\Src\stm32f4xx_it.c` | `USART1_IRQHandler()` | 进入 `HAL_UART_IRQHandler(&huart1)`。 |
| 9 | STM32 应用层 | `STM32_Project\User\user_app.c` | `HAL_UART_RxCpltCallback()` | 判断 `USART1`，把字节交给 `Bluetooth_OnRxByte()`，并重新启动接收。 |
| 10 | STM32 协议层 | `STM32_Project\User\bsp_bluetooth.c` | `Bluetooth_OnRxByte()` | 状态机解析 `AA 55 LEN CMD DATA CHECK`，校验通过后调用 `ControlMode_OnCommand()`。 |
| 11 | STM32 控制层 | `STM32_Project\User\control_mode.c` | `ControlMode_OnCommand()` | 0x01 手动：解析 vx/vy/wz（÷1000），限幅，记录目标，进入 `MODE_MANUAL`。 |
| 12 | STM32 主循环 | `STM32_Project\User\user_app.c` | `User_Loop()` | 主循环不断调用 `ControlMode_Poll()`。 |
| 13 | STM32 控制层 | `STM32_Project\User\control_mode.c` | `ControlMode_Poll()` | 每 20ms 执行一次控制；手动模式下用 `RampToward()` 做加速度平滑。 |
| 14 | STM32 控制层 | `STM32_Project\User\control_mode.c` | `ControlMode_RunSpeedLoop()` | 调用运动学、归一化、最小驱动缩放，然后调用 `Motor_SetSpeed()`。 |
| 15 | STM32 运动学层 | `STM32_Project\User\chassis_control.c` | `Chassis_Inverse()` | 用轴距 130mm、轮距 123.5mm，把 vx/vy/wz 解算成 FL/FR/RL/RR 四轮线速度。 |
| 16 | STM32 执行器层 | `STM32_Project\User\bsp_motor.c` | `Motor_SetSpeed()` | 对四轮速度限幅到 -1~1，调用 `DriverComm_SendCar()`。 |
| 17 | STM32 驱动通信层 | `STM32_Project\User\driver_comm.c` | `DriverComm_SendCar()` | 格式化成 `$Car:w1,w2,w3,w4!`（3 位小数），通过 `HAL_UART_Transmit(&huart2)` 发给驱动模块。 |
| 18 | STM32 外设层 | `STM32_Project\CubeMX\MecanumCar\Core\Src\usart.c` | `MX_USART2_UART_Init()` | USART2 配置为 PA2/PA3、115200、8N1。 |
| 19 | 驱动模块（工程外） | 松甲四路编码器电机驱动模块 | 内部解析 `$Car` | 模块按内置速度闭环驱动 A/B/C/D 四路 AT8236 H 桥，四个电机转动。 |

### 2.2 反馈链路：四个轮子 → 编码器 → STM32 → PC

| 步骤 | 层级 | 文件 | 函数/位置 | 发生什么 |
|---|---|---|---|---|
| 1 | 驱动模块（工程外） | 松甲四路驱动模块 | 编码器采样 | 四个电机编码器输出 A/B 相，模块统计 20ms 计数和累计计数。 |
| 2 | STM32 控制层 | `STM32_Project\User\control_mode.c` | `ControlMode_Poll()` | 每 20ms 调 `Encoder_Request20ms()`，每 5 个周期调 `Encoder_RequestTotal()`，每 50 个周期读电压。 |
| 3 | STM32 传感器层 | `STM32_Project\User\bsp_encoder.c` | `Encoder_Request20ms()` / `Encoder_RequestTotal()` | 调 `DriverComm_RequestEncoder20ms/Total()`，向模块发 `$MOTOR_4CH_READ:...!`。 |
| 4 | STM32 驱动通信层 | `STM32_Project\User\driver_comm.c` | `DriverComm_RequestEncoder20ms/Total()` | 通过 USART2 发送文本读取命令。 |
| 5 | 驱动模块（工程外） | 松甲四路驱动模块 | UART 回复 | 返回 `$MOTOR_4CH_Encoder_20ms:...!`、`$MOTOR_4CH_Encoder_Total:...!`。 |
| 6 | STM32 中断层 | `STM32_Project\CubeMX\MecanumCar\Core\Src\stm32f4xx_it.c` | `USART2_IRQHandler()` | 进入 `HAL_UART_IRQHandler(&huart2)`。 |
| 7 | STM32 应用层 | `STM32_Project\User\user_app.c` | `HAL_UART_RxCpltCallback()` | 判断 `USART2`，交给 `DriverComm_OnRxByte()`，并重新启动接收。 |
| 8 | STM32 驱动通信层 | `STM32_Project\User\driver_comm.c` | `DriverComm_OnRxByte()` | 用 `sscanf` 解析 20ms/累计计数/电压，存入 `DriverComm_Data_t g_data`。 |
| 9 | STM32 传感器层 | `STM32_Project\User\bsp_encoder.c` | `Encoder_GetCounts()` / `Encoder_GetCounts20ms()` / `Encoder_GetWheelSpeeds()` / `Encoder_CountsToDistance()` | 把计数减去零点，按 2464 counts/rev 和 80mm 轮径换算成距离/线速度。 |
| 10 | STM32 控制层 | `STM32_Project\User\control_mode.c` | `ControlMode_SendStatus()` / `ControlMode_SendCurve()` | 每 100ms 组 0x81 状态帧、0x82 曲线帧。 |
| 11 | STM32 协议层 | `STM32_Project\User\bsp_bluetooth.c` | `Bluetooth_SendFrame()` | 加 `AA 55 LEN CMD DATA CHECK`，通过 `HAL_UART_Transmit(&huart1)` 发蓝牙；若 `CFG_DEBUG_BRIDGE_ENABLE=1` 同时发 USART3。 |
| 12 | 蓝牙/硬件层 | HC-04（工程外） | 透传 | 把状态帧通过 SPP 发回 PC。 |
| 13 | PC 传输层 | `PC_上位机\serial_worker.py` | `SerialWorker.run()` | 从 COM7 读取字节，`FrameParser.feed()` 逐字节解析。 |
| 14 | PC 协议层 | `PC_上位机\protocol.py` | `parse_status()` / `parse_curve()` | 解析 mode/battery/enc/speed 和 target/actual。 |
| 15 | PC 界面层 | `PC_上位机\ui\main_window.py` | `_on_status()` / `_on_curve()` | 更新模式、电压、四轮速度、编码器，并把曲线数据交给 `CurvePanel`。 |
| 16 | PC 控件层 | `PC_上位机\widgets\curve_panel.py` | `CurvePanel.update_data()` | 刷新四轮目标/实际速度曲线。 |

### 2.3 有线 COM5 调试链路（当前联调常用）

| 步骤 | 文件/函数 | 说明 |
|---|---|---|
| 1 | `PC_上位机\serial_worker.py` → `SerialWorker.send_frame()` | 把同样的二进制帧写到 COM5（115200）。 |
| 2 | `STM32_Project\CubeMX\MecanumCar\Core\Src\usart.c` → `MX_USART3_UART_Init()` | USART3 = PB10/PB11，115200。 |
| 3 | `STM32_Project\CubeMX\MecanumCar\Core\Src\stm32f4xx_it.c` → `USART3_IRQHandler()` | 进入 `HAL_UART_IRQHandler(&huart3)`。 |
| 4 | `STM32_Project\User\user_app.c` → `HAL_UART_RxCpltCallback()` | `USART3` 的字节也交给 `Bluetooth_OnRxByte()`，即复用同一套协议。 |
| 5 | `STM32_Project\User\bsp_bluetooth.c` → `Bluetooth_SendFrame()` | `CFG_DEBUG_BRIDGE_ENABLE=1` 时，状态帧同时写 USART3，所以 COM5 也能看到遥测。 |

### 2.4 独立测试工程链路（COM5 文本命令）

| 步骤 | 文件/函数 | 说明 |
|---|---|---|
| 1 | 串口助手/PC 发送 `car 0.3 0 0` | 文本命令，不是二进制协议。 |
| 2 | `Test_Project\MecanumTest\Test\test_app.c` → `Test_OnRxByte()` | 按 `\r`/`\n` 收一行。 |
| 3 | `test_app.c` → `Test_Parse()` | 识别 `help/stop/bat/enc/enczero/car/wheel/raw`。 |
| 4 | `test_app.c` → `Test_Car()` / `Test_Wheel()` | 解析参数，调用 `Chassis_Inverse()`，归一化后调用 `DriverComm_SendCar()`。 |
| 5 | `driver_comm.c` → `DriverComm_SendCar()` | 向 USART2 发 `$Car:...!`。 |
| 6 | 驱动模块 → USART2 → `DriverComm_OnRxByte()` | 回传编码器/电压，存入 `g_data`。 |
| 7 | `test_app.c` → `Test_Enc()` | 把 20ms/累计计数以文本打印到 COM5。 |

### 2.5 文本数据流图

```text
[PC UI]
  MainWindow._manual_tick()
    -> protocol.cmd_manual()
      -> protocol.build_frame()
        -> SerialWorker.send_frame()
          -> COM7 / 蓝牙SPP / HC-04
            -> STM32 USART1 (PA10 RX, 9600)
              -> USART1_IRQHandler()
                -> HAL_UART_RxCpltCallback()
                  -> Bluetooth_OnRxByte()
                    -> ControlMode_OnCommand()
                      -> ControlMode_Poll() (每20ms)
                        -> RampToward()  // 加速度平滑
                        -> ControlMode_RunSpeedLoop()
                          -> Chassis_Inverse()  // 麦轮逆运动学
                          -> Motor_SetSpeed()   // 限幅到 -1~1
                            -> DriverComm_SendCar() // "$Car:..."
                              -> STM32 USART2 (PA2 TX, 115200)
                                -> 松甲四路驱动模块
                                  -> 内部速度闭环 + AT8236 H桥
                                    -> A/B/C/D 四个电机转动

反馈：
四轮编码器 -> 驱动模块 -> USART2 -> DriverComm_OnRxByte()
  -> bsp_encoder.c 换算
    -> ControlMode_SendStatus()/SendCurve()
      -> Bluetooth_SendFrame()
        -> USART1 -> HC-04 -> COM7 -> SerialWorker -> FrameParser
          -> MainWindow._on_status()/_on_curve()
            -> 状态栏/曲线
```

---

## 3. 可调参数清单

### 3.1 主固件 `config.h` 宏定义

文件：`STM32_Project\User\config.h`

| 参数 | 当前值 | 单位 | 影响什么 | 改动后会改变什么现象 |
|---|---:|---|---|---|
| `CFG_FW_VER_MAJOR` | 0 | 版本号 | 固件版本标识 | 仅影响版本显示，不影响控制。 |
| `CFG_FW_VER_MINOR` | 1 | 版本号 | 固件版本标识 | 仅影响版本显示。 |
| `CFG_BLUETOOTH_BAUD` | 9600 | bps | USART1 蓝牙波特率 | 与 HC-04 实际波特率不一致会导致蓝牙完全收不到/发不出；目前 `usart.c` 已引用此宏。 |
| `CFG_DRIVER_BAUD` | 115200 | bps | 注释上表示驱动模块波特率 | **当前 `usart.c` 未引用它**，USART2 实际硬编码 115200；只改此宏不会改变驱动串口。 |
| `CFG_DEBUG_BAUD` | 115200 | bps | 注释上表示调试串口波特率 | **当前 `usart.c` 未引用它**，USART3 实际硬编码 115200；只改此宏不会改变调试串口。 |
| `CFG_WHEEL_DIAMETER_MM` | 80.0 | mm | 速度/距离换算、`$MOTOR_PARAM` 轮径 | 改大 → 同样计数换算出的线速度/距离变大；改小则变小。 |
| `CFG_WHEELBASE_MM` | 130.0 | mm | 麦轮逆运动学的半轴距 | 改大 → 旋转时轮速差变大；改小则旋转更“慢/柔”。 |
| `CFG_TRACK_MM` | 123.5 | mm | 麦轮逆运动学的半轮距 | 改大 → 横移/旋转的轮速差变大；改小则变小。 |
| `CFG_ENCODER_CPR` | 2464.0 | counts/rev | 编码器计数→圈数→速度/距离 | 改大 → 同样计数被算成更小速度/距离；改小则更大。 |
| `CFG_MAX_SPEED_M_S` | 1.0 | m/s | 初始 `g_max_speed`，限幅 vx/vy | 改大 → 手动前后/左右最大速度变大；改小则变小。 |
| `CFG_MAX_OMEGA_RAD_S` | 1.0 | rad/s | 初始 `g_max_omega`，限幅 wz | 改大 → 手动旋转最大角速度变大；改小则变小。 |
| `CFG_MAX_WHEEL_SPEED_M_S` | 1.0 | m/s | 把轮速归一化到 `$Car` 的 -1~1 | 改大 → 同样 m/s 对应的 `$Car` 数值变小，车更“慢”；改小则更快、更容易饱和。 |
| `CFG_MIN_DRIVE` | 0.30 | 归一化 -1~1 | 最小有效驱动；低于它时整体放大 | 改大 → 起步更猛、低速死区更大；改小 → 允许更慢但可能震动。 |
| `CFG_ACCEL_V` | 1.0 | m/s² | 线速度平滑的加速度上限 | 改大 → 起步/停止更急；改小 → 更柔和但更慢。 |
| `CFG_ACCEL_W` | 3.0 | rad/s² | 角速度平滑的加速度上限 | 改大 → 旋转起停更急；改小 → 更柔和。 |
| `CFG_ROTATE_DRIVE` | 0.60 | 归一化 -1~1 | 定时原地旋转的四轮速度 | 改大 → 旋转更快、可能过冲；改小 → 更慢、可能不到位。 |
| `CFG_ROTATE_MS_PER_90` | 900 | ms | 转 90° 的时间 | 改大 → 同样指令转得更多；改小 → 转得更少。 |
| `CFG_ROTATE_TOL_DEG` | 2.0 | 度 | 原编码器角度控制的容差 | **当前时间控制旋转未引用**，改它暂不生效。 |
| `CFG_YAW_SIGN` | 1.0 | 符号 | 原偏航角符号 | **当前时间控制旋转未引用**，改它暂不生效。 |
| `CFG_DEBUG_BRIDGE_ENABLE` | 1 | 0/1 | 是否把协议帧同时发 USART3 | 1 → COM5 也能看到遥测；0 → 只有蓝牙/USART1 有遥测。 |
| `CFG_LOOP_MS` | 20 | ms | 控制周期 | 改大 → 控制更慢、平滑步长更大；改小 → 控制更频繁、CPU/串口负担更大。 |
| `CFG_TELEMETRY_MS` | 100 | ms | 状态/曲线上报周期 | 改小 → 曲线更密、串口负担更大；改大 → 曲线更稀疏。 |
| `CFG_POS_KP` | 0.8 | PID 比例 | 位置环初始 Kp | 改大 → 位置停更快、易超调；改小 → 更慢。 |
| `CFG_POS_KI` | 0.0 | PID 积分 | 位置环初始 Ki | 改大 → 消除静差、易积分饱和/超调。 |
| `CFG_POS_KD` | 0.0 | PID 微分 | 位置环初始 Kd | 改大 → 抑制超调、对噪声更敏感。 |
| `CFG_SOFT_BRAKE_DECEL` | 0.02 | m/s 每 20ms | 缓停每周期减少的目标速度 | 折算约 1.0 m/s²；改大 → 停得更快；改小 → 停得更慢。 |
| `CFG_ROUTE_SIDE_MM` | 800 | mm | 注释上表示正方形边长 | **当前主固件 `route.c` 未引用**；PC 路线用的是界面里的边长输入。 |

### 3.2 主固件 `control_mode.c` 全局变量与结构体

| 名称 | 当前值/类型 | 单位 | 影响什么 | 改动后的现象 |
|---|---|---|---|---|
| `g_mode` | `MODE_IDLE`（枚举） | — | 当前运行模式 | 改初值会改变上电默认模式，不建议。 |
| `g_target_vx/vy/wz` | 0.0 / float | m/s、m/s、rad/s | 手动目标速度 | 运行中由协议写入，不是手动调参项。 |
| `g_max_speed` | 1.0 / float | m/s | 运行时线速度限幅 | 由 0x0C 指令或初值改变；影响最大速度。 |
| `g_max_omega` | 1.0 / float | rad/s | 运行时角速度限幅 | 同上。 |
| `g_pos_pid` | `PID_HandleTypeDef` | — | 位置环参数和状态 | 由 `CFG_POS_*` 初始化，可由 0x08 在线修改。 |
| `g_wheel_target[4]` | 0.0 ×4 / float | 归一化 -1~1 | 四轮目标（发给 `$Car`，也用于曲线目标） | 运行中计算得到。 |
| `g_wheel_actual[4]` | 0.0 ×4 / float | m/s | 四轮实际线速度（曲线/状态） | 运行中由编码器换算。 |
| `g_pos_start` / `g_pos_target` | 0.0 / float | m | PID 精准停起点/相对目标 | 由 0x04 写入。 |
| `g_rotate_end_tick` | 0 / uint32 | ms tick | 定时旋转结束时刻 | 由 0x0D 写入。 |
| `g_rotate_dir` | +1.0 / float | 符号 | 旋转方向（+左/-右） | 由 0x0D 写入。 |
| `g_ramp_vx/vy/wz` | 0.0 / float | m/s、m/s、rad/s | 平滑后的实际目标 | 运行中由 `RampToward()` 更新。 |
| `g_accel_v` | 1.0 / float | m/s² | 线加速度限制 | 由 0x0E 在线修改。 |
| `g_accel_w` | 3.0 / float | rad/s² | 角加速度限制 | 由 0x0E 在线修改。 |
| `g_last_tick` / `g_last_tele` / `g_tick_count` | 0 / uint32 | ms、ms、计数 | 控制/上报调度 | 一般不需要手动改。 |
| `POS_STOP_TOL_MM` | 10.0 | mm | 位置停到位容差 | 改大 → 更早判定到位（误差更大）；改小 → 更精确但可能来回找。 |

### 3.3 `driver_comm.h` 结构体字段

| 字段 | 类型 | 单位/含义 | 影响什么 | 说明 |
|---|---|---|---|---|
| `encoder_total[4]` | int32×4 | 累计计数 | 距离/位置环反馈 | 来自模块 `$MOTOR_4CH_Encoder_Total`。 |
| `encoder_20ms[4]` | int16×4 | 每20ms计数 | 速度换算/曲线 | 来自模块 `$MOTOR_4CH_Encoder_20ms`。 |
| `battery_raw` | uint16 | 原始电压值（实测约 12300，按 mV 使用） | 状态栏电压 | 模块返回单位需确认。 |
| `encoder_total_ok` | uint8 | 0/1 | 诊断标志 | 是否已收到累计计数。 |
| `encoder_20ms_ok` | uint8 | 0/1 | 诊断标志 | 是否已收到 20ms 计数。 |

### 3.4 `pid.h` 结构体字段

| 字段 | 类型 | 单位 | 影响什么 | 改动后的现象 |
|---|---|---|---|---|
| `kp` | float | 输出/误差 | 比例增益 | 变大 → 响应快、易超调/振荡；变小 → 慢。 |
| `ki` | float | 输出/(误差·秒) | 积分增益 | 变大 → 消静差快、易饱和；变小 → 静差残留。 |
| `kd` | float | 输出/(误差变化) | 微分增益 | 变大 → 抑制超调、对噪声敏感。 |
| `out_max` | float | 同输出 | 输出上限 | 限制最大速度/最大修正量。 |
| `out_min` | float | 同输出 | 输出下限 | 限制反向最大修正量。 |
| `integral` | float | 积分累加 | 运行状态 | 不建议手动改。 |
| `prev_error` | float | 上次误差 | 运行状态 | 不建议手动改。 |

### 3.5 其他主固件全局/常量

| 名称 | 位置 | 当前值 | 单位 | 影响 |
|---|---|---:|---|---|
| `g_zero[4]` | `bsp_encoder.c` | 0 | 计数 | 编码器软件零点；由 `Encoder_SetZero()` 写入。 |
| `BT_SOF1` / `BT_SOF2` | `bsp_bluetooth.c` | 0xAA / 0x55 | — | 协议帧头；改动会导致协议不兼容。 |
| `BT_RX_BUF_SIZE` | `bsp_bluetooth.c` | 64 | 字节 | 最大帧正文长度；改小会截断长帧。 |
| `g_side_mm` | `route.c` | 800 | mm | 主固件路线占位值；当前路线未实现，实际不生效。 |
| `PI_F` | `bsp_encoder.c` | 3.14159265 | — | 距离/速度换算常量。 |
| 电机参数 11 / 56 | `bsp_motor.c`、`Test/test_app.c` | 11 / 56 | 线数 / 减速比 | `$MOTOR_PARAM` 的编码器线数和减速比；与电机实际规格不一致会影响模块内部闭环换算。 |

### 3.6 测试工程参数

文件：`Test_Project\MecanumTest\Test\config.h`

| 参数 | 当前值 | 单位 | 影响 |
|---|---:|---|---|
| `CFG_WHEEL_DIAMETER_MM` | 80.0 | mm | 测试工程速度/距离换算 |
| `CFG_WHEELBASE_MM` | 130.0 | mm | 测试工程麦轮逆解算 |
| `CFG_TRACK_MM` | 123.5 | mm | 测试工程麦轮逆解算 |
| `CFG_ENCODER_CPR` | 2464.0 | counts/rev | 测试工程速度/距离换算 |
| `CFG_MAX_WHEEL_SPEED_M_S` | 1.0 | m/s | `$Car` 归一化基准 |

测试工程 `test_app.c` 其他常量：

| 名称 | 当前值 | 单位 | 影响 |
|---|---:|---|---|
| `CMD_LINE_MAX` | 64 | 字节 | 单条文本命令最大长度 |
| 主循环周期 | 20 | ms | 编码器/电压请求周期 |
| 20ms 请求 | 每周期 | — | `encoder_20ms` 刷新率 |
| 累计计数请求 | 每5周期（100ms） | — | `encoder_total` 刷新率 |
| 电压请求 | 每50周期（1s） | — | 电池刷新率 |
| 电机线数/减速比 | 11 / 56 | — | `$MOTOR_PARAM` 参数 |

### 3.7 PC 上位机 `config.py`

| 参数 | 当前值 | 单位 | 影响 | 改动后的现象 |
|---|---:|---|---|---|
| `WINDOW_W` / `WINDOW_H` | 1280 / 820 | px | 窗口尺寸 | 改变界面大小。 |
| `SERIAL_BAUDRATE` | 9600 | bps | 默认波特率 | 与 HC-04 不一致会收不到数据。 |
| `BAUDRATE_OPTIONS` | [9600, 115200] | bps | 可选波特率 | 增加选项可试其他波特率。 |
| `PORT_BAUDRATE` | `{"COM5":115200}` | bps | COM5 自动用 115200 | 改这里可让别的端口自动匹配波特率。 |
| `SERIAL_TIMEOUT` | 0.05 | s | 串口读超时 | 改小更灵敏、CPU占用高；改大更迟钝。 |
| `DEFAULT_PORT` | COM7 | — | 默认端口 | 改错会连错口。 |
| `PORT_CANDIDATES` | COM7/COM8/COM5 | — | 下拉候选 | 增删候选端口。 |
| `TX_INTERVAL_MS` | 50 | ms | 手动指令发送周期 | 改小更跟手、串口负担大；改大更迟钝。 |
| `WHEEL_DIAMETER_MM` | 80.0 | mm | 演示模式/换算 | 只影响上位机演示/计算。 |
| `WHEELBASE_MM` | 130.0 | mm | 演示模式/运动学 | 只影响上位机演示/计算。 |
| `TRACK_MM` | 123.5 | mm | 演示模式/运动学 | 只影响上位机演示/计算。 |
| `ENCODER_CPR` | 2464.0 | counts/rev | 演示模式计数 | 只影响演示。 |
| `MAX_VX` | 1.00 | m/s | 摇杆满量程前后速度 | 改大 → 满杆更快。 |
| `MAX_VY` | 1.00 | m/s | 摇杆满量程左右速度 | 改大 → 横移更快。 |
| `MAX_WZ` | 1.50 | rad/s | 摇杆满量程旋转速度 | 改大 → 旋转更快。 |
| `DEFAULT_POS_KP/KI/KD` | 0.80 / 0.00 / 0.00 | — | PID 页默认值 | 改后每次打开默认值变化。 |
| `DEFAULT_ROUTE_SIDE_MM` | 800 | mm | 路线页默认边长 | 改后默认路线尺寸变化。 |
| `CURVE_MAX_POINTS` | 400 | 点 | 曲线缓存长度 | 改大 → 历史更长、内存更大。 |
| 协议码 `CMD_*` / `RPT_*` | 见 config.py | — | 协议约定 | 改动必须同步 STM32，否则通信失败。 |

### 3.8 PC 界面默认值与范围（`main_window.py`）

| 控件/参数 | 当前值/范围 | 单位 | 影响 |
|---|---:|---|---|
| vx 滑块 | 默认 1.00，范围 0.10~1.20 | m/s | 手动前后最大速度 |
| vy 滑块 | 默认 1.00，范围 0.10~1.20 | m/s | 手动左右最大速度 |
| wz 滑块 | 默认 1.50，范围 0.20~3.00 | rad/s | 手动旋转最大角速度 |
| PID 精准停距离 | 默认 300，范围 -5000~5000 | mm | 位置停目标 |
| 路线边长 | 默认 800，范围 100~1000 | mm | 正方形边长 |
| 路线速度 | 默认 0.40，范围 0.30~1.00 | m/s | 路线前进速度 |
| 路线停顿 | 默认 500，范围 0~3000 | ms | 每段前进/转向后的停顿 |
| PID Kp/Ki/Kd | 默认 0.8/0/0，范围 0~20，步进 0.01 | — | 位置环参数 |
| vmax | 默认 1.00，范围 0.05~2.00 | m/s | 下发限幅 |
| wmax | 默认 1.50，范围 0.10~3.00 | rad/s | 下发限幅 |
| 线加速度 | 默认 1.00，范围 0.10~5.00 | m/s² | 平滑起步/停止 |
| 角加速度 | 默认 3.00，范围 0.50~10.00 | rad/s² | 平滑旋转起停 |
| 特殊指令暂停 | 刹车/全停 0.6s，旋转 2.0s | s | 防止手动 tick 覆盖特殊指令 |
| 路线运行暂停 | 3600s（直到结束） | s | 路线期间禁止手动发送 |
| 路线转向等待 | 1200 | ms | 等待固件定时 90° 转完 |
| 链路测试超时 | 1500 | ms | 心跳 ACK 等待时间 |
| 链路无数据判定 | 1.5 | s | 超过该时间无 RX 显示“无数据” |
| 摇杆灵敏度指数 | 0.7 | — | 轻推更灵敏；1.0 为线性 |
| 摇杆头半径 | 26 | px | 仅显示 |
| 摇杆边距 | 18 | px | 仅显示 |
| 演示模式电池 | 12300 | mV | 仅演示显示 |
| 演示模式跟随系数 | 0.35 | — | 演示速度跟随快慢 |
| 演示模式 PID 停容差 | 0.01 | m | 演示到位判定 |

### 3.9 值得注意的硬编码值

| 位置 | 值 | 说明 |
|---|---:|---|
| `usart.c` USART2 | 115200 | 驱动模块串口实际波特率；`CFG_DRIVER_BAUD` 未引用。 |
| `usart.c` USART3 | 115200 | 调试/COM5 实际波特率；`CFG_DEBUG_BAUD` 未引用。 |
| `bsp_motor.c` Motor_Init | 11 / 56 | 编码器线数/减速比硬编码，不是宏。 |
| `control_mode.c` 旋转 | `CFG_ROTATE_DRIVE=0.6` | 旋转时四轮直接给 ±0.6。 |
| `control_mode.c` 旋转 | `CFG_ROTATE_MS_PER_90=900ms` | 时间控制，不是编码器闭环。 |
| `control_mode.c` 位置停 | `POS_STOP_TOL_MM=10mm` | 到位容差。 |
| `main.c` 时钟 | PLLM=8, PLLN=336, PLLP=2, PLLQ=7 | 168MHz；改动会影响串口波特率精度。 |
| `test_app.c` | 20ms / 5 / 50 | 编码器/电压请求节奏。 |
| `demo_worker.py` | 50ms / 0.35 / 0.01 | 演示循环/跟随/到位阈值。 |

---

## 4. 不确定或假设不清的地方（请确认）

1. **轮子安装方向与 A/B/C/D 的对应关系**  
   当前代码假设：A=左前、B=右前、C=左后、D=右后；正速度时 A/C 逆时针、B/D 顺时针。请确认实车四个轮子的实际位置和辊轮方向（X 型还是 O 型）。

2. **编码器倍频与计数单位**  
   当前代码按 `11PPR × 56 × 4 = 2464 counts/输出转` 计算速度/距离。但之前旋转测试里 `encoder_total` 的累计值看起来远大于按此换算的预期，需确认模块 `encoder_total/encoder_20ms` 到底是 1×、2×、4×，以及是否已包含减速比。

3. **电机/编码器 6P 插头线序**  
   当前假设模块座 `M-,5V,A,B,GND,M+` 与电机插头完全对应，且编码器 Vcc/GND/A/B 都接触良好。之前出现过某些通道为 0、方向相反的现象，请确认实际线序和插头接触。

4. **PWM/电机极性**  
   当前假设 `$Car` 正值使车前进；若某个轮子反向，需要在硬件上交换 M+/M-，或在软件里增加单轮符号。当前代码没有“单轮方向取反”的宏，请确认是否需要留这个入口。

5. **`$Car` 的物理量纲**  
   当前把 `CFG_MAX_WHEEL_SPEED_M_S=1.0` 当作 `$Car` 的 -1~1 对应 1.0 m/s 轮速。这个“满量程对应多少 m/s”没有实测，请确认实际最大轮速。

6. **HC-04 的实际波特率**  
   当前固件/上位机默认 9600。请确认模块当前确实是 9600（可用 AT+RX 查询），还是 38400/115200。

7. **HC-04 是否处于透明传输模式**  
   当前假设 KEY/STA 悬空、模块处于 SPP 透明模式。请确认 KEY 没有被拉高/拉低，LED 常亮表示已连接，且模块没有停留在 AT 模式。

8. **COM7/COM8 的方向**  
   你当前说 COM7=传出、COM8=传入，上位机默认已改 COM7。请确认重新配对后这个方向是否仍然稳定。

9. **电池电压单位**  
   当前把 `battery_raw` 当作 mV 显示（约 12300）。请确认模块 `$MOTOR_4CH_Battery` 返回的是 mV、0.01V 还是 ADC 原始值。

10. **`$MOTOR_PARAM` 的三个参数单位**  
    当前发的是 `8,11,56`（轮径 cm、编码器线数、减速比）。请确认模块要求的是“轮径 cm / 磁编码器环线数 / 减速比”，以及你的电机是否确实是 11 线、56 减速比。

11. **固定路线的实现位置**  
    当前固件 `route.c` 是空实现；上位机“固定路线”是按时间执行“前进→停顿→左转90°→停顿”。请确认你希望路线由上位机执行，还是必须由 STM32 脱机执行。

12. **原地旋转的角度精度**  
    当前旋转是**时间控制**（90°=900ms，轮速 0.6），不是编码器闭环。实际角度会受电池电压、地面摩擦、轮子打滑影响；请确认是否接受这种开环方式，还是必须做编码器闭环角度。

13. **`CFG_ROTATE_TOL_DEG` 和 `CFG_YAW_SIGN` 的用途**  
    这两个宏目前未被时间控制旋转引用，是早期编码器角度方案的遗留。请确认是否保留给后续编码器闭环偏航，还是删除。

14. **速度平滑 vs 速度 PID**  
    当前 STM32 做的是**加速度限制**（`RampToward`），速度环仍在驱动模块内部；上位机的“速度平滑”不是速度 PID。请确认你要的是“平滑加减速”，还是“STM32 自己的速度环 PID”。

15. **位置环 PID 的对象**  
    当前 `0x04 PID精准停` 只对“平均行驶距离”做位置 PID，输出 vx，再做麦轮逆解算；不是四轮独立位置环。请确认这是否符合你的“PID精准停”预期。

16. **`CFG_SOFT_BRAKE_DECEL` 的单位**  
    当前每 20ms 减 0.02 m/s，折算约 1.0 m/s²。请确认你想要的是“每周期减 0.02”还是“每秒减 0.02”。

17. **重复的 `User\User` 目录**  
    `STM32_Project\CubeMX\MecanumCar\User\User\` 是过期副本，Keil 实际引用 `MecanumCar\User`。请确认是否允许后续删除这个重复目录（本次未动）。

18. **`CFG_ROUTE_SIDE_MM` 未使用**  
    主固件宏 `CFG_ROUTE_SIDE_MM` 当前没有被 `route.c` 引用；PC 路线用的是界面输入。请确认是否要把它作为固件路线的默认边长。

19. **"PID调参"页的 0x07 指令**  
    协议里 0x07 现在被固件当作“预留/忽略”，0x08 才是位置环 PID。请确认上位机是否还需要“速度环 PID”入口，还是只保留位置环。

20. **当前烧录的是哪套固件**  
    代码里同时存在主工程和测试工程；你最近一次烧录/当前板内固件版本需要确认。本报告不能从代码判断当前 Flash 里是哪一版。

21. **轮径/轴距/轮距的测量基准**  
    当前使用 80mm / 130mm / 123.5mm。请确认 130mm 是“前后轮中心距”、123.5mm 是“左右轮中心距”，而不是外缘距离。

22. **`CFG_MAX_SPEED_M_S` 与 `CFG_MAX_WHEEL_SPEED_M_S` 的关系**  
    当前两者都为 1.0；前者限制车体 vx/vy，后者用于轮速归一化。请确认这是否是你想要的“满杆 1.0 m/s”。

23. **测试工程与主工程的参数同步**  
    测试工程有自己的 `Test\config.h`（80/130/123.5/2464/1.0），主工程有 `User\config.h`。请确认后续调参时以哪一份为唯一基准，避免两边不一致。

24. **电机型号细节**  
    当前硬编码 11 线、56 减速比；请确认你的 JGB37-520 具体变体（编码器线数、减速比、额定转速）与这两个值一致。

25. **DemoWorker 对旋转/加速度指令的处理**  
    `DemoWorker` 目前只处理手动/刹车/PID停/路线/参数等，未处理 0x0D（旋转）和 0x0E（加速度）；演示模式下这两个按钮只记录 TX，不会产生模拟动作。请确认是否需要补齐演示模式。

---

## 5. 最小改动清单（按优先级）

> 原则：先解决“通信链路”和“标定”问题，再做控制精度；每一步只改必要文件，不做大重构。

### P0：蓝牙链路（先让 COM7 稳定收到遥测）

| 序号 | 改动文件/函数 | 最小改动 | 原因 | 验证 |
|---|---|---|---|---|
| P0-1 | `config.py` / `main_window.py` | 默认端口已设 COM7、9600；确认连接后状态栏显示“已连接（数据正常）”且 RX 字节增加 | COM7 是当前“传出”口 | 点“测试链路”，日志出现“链路测试成功：收到心跳ACK” |
| P0-2 | `STM32_Project\User\config.h` | 确认 `CFG_BLUETOOTH_BAUD=9600` | 与 HC-04 默认一致 | 蓝牙能收到 0x81/0x82 帧 |
| P0-3 | 硬件接线 | 确认 HC-04 `3V3/GND/RXD→PA9/TXD→PA10`，KEY 悬空，共地 | 之前 COM7 写入成功但无回包，像是 HC-04↔STM32 串口未接好 | 上位机 RX 字节持续增长 |
| P0-4 | `usart.c`（可选） | 若 HC-04 实际不是 9600，只改 `CFG_BLUETOOTH_BAUD`（USART1 已引用该宏） | 避免改多处 | 改后重新编译烧录，心跳 ACK 成功 |

### P1：编码器标定（影响速度/距离/PID停）

| 序号 | 改动文件/函数 | 最小改动 | 原因 | 验证 |
|---|---|---|---|---|
| P1-1 | `Test_Project\MecanumTest\Test\config.h` 与 `STM32_Project\User\config.h` | 用测试工程 `car 0.3 0 0` 跑固定时间，记录 `enc` 累计差值，反算“每输出转计数”；把两处 `CFG_ENCODER_CPR` 改成实测值 | 当前 2464 是理论值，旋转测试的累计值疑似偏大 | 手动前进 1m，状态/曲线距离接近 1m |
| P1-2 | `bsp_motor.c` / `Motor_SetSpeed`（可选） | 若某个轮方向相反，增加 4 个符号宏（如 `CFG_WHEEL_SIGN_A..D`），在 `Motor_SetSpeed` 里乘上 | 不改硬件也能纠正单轮方向 | 单独 `wheel 0 0.3` 看方向 |
| P1-3 | `bsp_encoder.c`（可选） | 若编码器符号相反，增加 4 个符号宏或在 `Encoder_GetCounts` 里乘符号 | 保证速度/距离方向一致 | `enc` 正负与运动方向一致 |

### P2：原地旋转标定（45°/90°）

| 序号 | 改动文件/函数 | 最小改动 | 原因 | 验证 |
|---|---|---|---|---|
| P2-1 | `config.h` / `CFG_ROTATE_MS_PER_90` | 实测 90° 转多了就减小，转少了就增大；45° 自动按比例 | 当前是时间控制，不是闭环 | 左/右转 90° 目测到位 |
| P2-2 | `config.h` / `CFG_ROTATE_DRIVE` | 若旋转太慢/太快，微调 0.6 | 影响旋转速度 | 旋转平稳、不明显打滑 |
| P2-3 | `control_mode.c` / `MODE_ROTATE_ANGLE` | 若方向反了，交换 `w[0]` 与 `w[1]` 的符号，或把 `g_rotate_dir` 取反 | 当前方向按“正=左转”假设 | 左转按钮真的左转 |

### P3：固定路线（当前 PC 侧执行）

| 序号 | 改动文件/函数 | 最小改动 | 原因 | 验证 |
|---|---|---|---|---|
| P3-1 | `PC_上位机\ui\main_window.py` / `_route_forward` | 已加 `route_gen` 防旧定时器、已加停顿；确认 `QTimer.singleShot(1200)` 与固件 900ms 转向匹配 | 之前“瞬间跳到第3条边”是旧定时器叠加/节奏不匹配 | 观察进度按“前进-停顿-转向-停顿”推进 |
| P3-2 | `main_window.py` / `spin_route_speed` | 若实际边长不准，微调路线速度或增加“距离校准系数” | 当前按 `边长/速度` 估算时间，未用编码器闭环 | 走完一边后用尺量接近设定值 |
| P3-3 | `route.c` | 最小改动：保持空实现，PC 路线不要发 0x05；若必须脱机路线，再实现状态机（较大改动） | 当前 PC 路线不依赖固件 `route.c` | 确认 PC 路线按钮不走 0x05 |

### P4：速度平滑（不急起急停）

| 序号 | 改动文件/函数 | 最小改动 | 原因 | 验证 |
|---|---|---|---|---|
| P4-1 | `config.h` / `CFG_ACCEL_V`、`CFG_ACCEL_W` | 先保持 1.0 / 3.0；觉得起步太急就减小，太肉就增大 | 当前是加速度限制，不是速度 PID | 手动推杆，速度渐进变化 |
| P4-2 | 上位机“PID调参”页 | 用“速度平滑”组勾选/取消，观察差异 | 已提供独立选项 | 勾选时平缓，取消时急起急停 |
| P4-3 | （可选，较大改动）`control_mode.c` | 若要 STM32 速度环 PID，需要改用 `$Car_Pwm` + `encoder_20ms` 做速度闭环；这不是最小改动 | 当前速度环在模块内部 | 先确认是否真的需要 |

### P5：工程清理（不改变行为）

| 序号 | 改动文件/目录 | 最小改动 | 原因 |
|---|---|---|---|
| P5-1 | `STM32_Project\CubeMX\MecanumCar\User\User\` | 确认后删除这个过期副本，只保留 `MecanumCar\User` | 避免误改旧文件 |
| P5-2 | `PC_上位机\_*.py`、根目录 `_*.py` | 确认后删除临时诊断脚本 | 减少干扰 |
| P5-3 | `usart.c` | 可选：把 USART2/USART3 的 115200 改成引用 `CFG_DRIVER_BAUD`/`CFG_DEBUG_BAUD` | 让配置真正集中 |
| P5-4 | `DemoWorker` | 可选：补 0x0D/0x0E 的模拟处理 | 演示模式与真实模式一致 |
| P5-5 | `route.c` / `CFG_ROUTE_SIDE_MM` | 可选：删除未使用的宏/占位实现，或真正实现固件路线 | 避免“看起来有、实际没有” |

---

## 6. 只读声明

本次分析只读取了上述源文件，除本 Markdown 报告外，**没有修改任何源文件、没有重新编译、没有烧录**。  
最小改动清单中的条目需要你确认后再执行。
