Chen-long-bo/-/改造方案大纲_v1.md

# 改造方案大纲 v1（待你审核补充，暂不执行）

> 本文件只做“需求梳理 + 方案大纲”，暂不修改任何源文件。
> 你审核、补充、确认后，我再按阶段执行。

---

## 0. 我对你这次需求的逐条理解

### 0.1 关于“把上位机里直接操控部分的所有 PID 删去，但 PID 调参保留”

我理解为：

- 在**上位机“手动遥控”页**里，删除所有与 PID 直接操控有关的控件；
- **保留“PID调参”页**，继续用于位置环 PID 参数的下发/读取；
- PID 不再作为“手动遥控”的一部分，而是作为一个**独立的调试/调参功能**存在。

当前工程里，手动页与 PID 直接相关的部分是：

- `PC_上位机\ui\main_window.py` 中手动页的 **“PID精准停”分组**（距离输入 + “开始精准停”按钮）；
- 它发送 `0x04` 指令，让 STM32 进入 `MODE_POS_STOP`，用位置环 PID 走到目标距离。

我建议的删法是：

- 从“手动遥控”页删除“PID精准停”分组；
- 在“PID调参”页增加一个 **“PID测试”** 按钮（可选：输入测试距离，发 0x04），这样 PID 仍然可测，但不属于“直接操控”；
- 固件里的 `MODE_POS_STOP` 和 `pid.c` **保留**，因为 PID 调参页和未来的位置控制仍然需要它。

> 需你确认：这是否就是你要的“删掉直接操控 PID、保留 PID 调参”？

### 0.2 关于“没有实际数据而猜定的部分、所有非基础代码、需要函数/算法/调试参数的部分，单独拎出来供直接调试”

我理解为：

- 把当前工程里**靠假设、没有实测标定**的部分，以及**非基础、偏算法/协议/控制**的代码，单独整理成一个“调试层”；
- 调试层要能**直接操作/观察**，不是只写在文档里；
- 每个调试项要说明：
  - 调的是哪一块；
  - 这个参数影响什么；
  - 参数范围；
  - 怎么测量/怎么定；
  - 调错会有什么现象；
  - 调好后怎么验证。

我建议“非基础代码”的范围包括：

1. 麦克纳姆轮正/逆运动学（`chassis_control.c`）；
2. 编码器计数→速度/距离换算（`bsp_encoder.c`）；
3. 轮速归一化、最小驱动缩放（`control_mode.c` 的 `ControlMode_RunSpeedLoop`）；
4. 加速度平滑（`RampToward`）；
5. 位置环 PID（`pid.c` + `MODE_POS_STOP`）；
6. 定时原地旋转（`MODE_ROTATE_ANGLE`）；
7. 固定路线状态机（上位机 `_route_*` 方法，以及固件 `route.c` 占位）；
8. 蓝牙二进制协议（`bsp_bluetooth.c` + `protocol.py`）；
9. 驱动模块文本协议（`driver_comm.c` 的 `$Car`/`$MOTOR_4CH_READ`/`$MOTOR_PARAM`）；
10. 遥测状态/曲线组帧与解析；
11. 演示模式模拟逻辑（`demo_worker.py`）。

不纳入“非基础代码”的部分：

- CubeMX/HAL 初始化（`main.c`、`usart.c`、`stm32f4xx_it.c`、`system_stm32f4xx.c`、HAL 库）；
- GPIO/时钟/启动文件等基础工程配置；
- 纯 UI 布局/样式细节（但会讲“为什么这样设计”）。

> 需你确认：这个边界是否符合你的预期？有没有你觉得必须纳入的模块？

### 0.3 关于“教学文本，配示意图、思维导图、专业术语、专业技术解读”

我理解为：

- 不是只给结论，而是从**零基础**讲清楚：
  - 这个工程由哪些部分组成；
  - 每个文件为什么存在、删掉会怎样；
  - 每个算法是什么、为什么这样算；
  - 每个参数怎么测、怎么调、调错会怎样；
  - 常见故障怎么排查。
- 需要示意图/思维导图：
  - 系统架构图；
  - 数据流图；
  - 麦轮布局与辊轮方向图；
  - 编码器 A/B 相与倍频图；
  - PWM/H 桥/电机驱动图；
  - PID 框图/串级控制图；
  - 协议帧结构图；
  - 状态机图；
  - 标定流程图；
  - 知识思维导图。
- 需要专业术语解释：PWM、H 桥、PPR、CPR、正交解码、麦轮、逆运动学、PID、积分饱和、死区、SPP/BLE、UART、校验和、状态机等。

### 0.4 关于“小型可视化网站”

我理解为：

- 在工程目录里做一个**离线可打开**的小型网站；
- 用可视化方式展示：
  - 工程架构；
  - 数据流；
  - 代码地图；
  - 参数中心；
  - 标定向导；
  - 麦轮运动学；
  - PID 模拟；
  - 协议组帧/解析；
  - 故障排查；
  - 教学手册在线阅读。
- 网站要能让你“看懂”和“动手试”，不是静态截图。

### 0.5 关于“包括一个文件里的代码注释、作用、必要性、所采用技术”

我理解为：

- 每个源文件都要有“文件级说明”：
  - 它处于哪一层；
  - 作用是什么；
  - 为什么必要；
  - 用了什么技术/算法；
  - 关键函数/关键代码段解释；
  - 与其它文件的调用关系。
- 关键算法文件（如 `chassis_control.c`、`control_mode.c`、`pid.c`、`bsp_encoder.c`、`bsp_bluetooth.c`）需要**逐行/逐段讲解**；
- 非关键文件可以“函数级 + 关键行”讲解，避免把 HAL 库逐行抄一遍。

---

## 1. 关键歧义与需要你确认的点

### 1.1 “直接操控部分的所有 PID”到底删到什么程度？

当前手动页只有一个 PID 相关分组：

- “PID精准停”：输入距离，点“开始精准停”，发 0x04。

我建议：

- **方案 A（推荐）**：只删手动页的“PID精准停”分组；PID 调参页保留，并在 PID 页加“PID测试”按钮（测试距离 + 开始）。
- 方案 B：同时删掉固件里 `MODE_POS_STOP` 和 `pid.c`（但这样 PID 调参页就没有实际作用了，和“PID调参保留”矛盾）。
- 方案 C：删掉上位机所有 PID 控件（同样与“保留 PID 调参”矛盾）。

> 请确认是否采用 **方案 A**。

### 1.2 “非基础代码”的范围

建议按 0.2 的 11 项纳入；HAL/CubeMX/GPIO/时钟不纳入。

> 请确认，或补充你希望纳入/排除的模块。

### 1.3 “单独拎出来供直接调试”的形式

建议采用 **组合方案**：

1. **扩展 Test_Project**：把它从“硬件测试工程”升级为“算法/标定调试工程”，增加文本命令；
2. **上位机新增“调试中心”Tab**：把链路、编码器、旋转、最小驱动、轮子方向、几何、加速度、PID 测试集中在一个页面；
3. **参数手册 + 标定向导**：每个参数有范围、影响、测量方法；
4. **教学手册 + 可视化网站**：解释“为什么/怎么调”。

> 请确认是否接受这个组合，还是只想做文档、不做调试界面。

### 1.4 教学文本格式

建议：

- `教学手册.md`（主文本）；
- `diagrams\` 下的 SVG 示意图；
- `mindmap.svg` 或 Mermaid 思维导图；
- 后续可导出 PDF/DOCX（如果需要）。

> 请确认是否需要 PDF/DOCX 版本。

### 1.5 可视化网站技术

建议：

- 纯静态 HTML/CSS/JS，**无外部 CDN、无构建步骤**；
- 双击 `index.html` 即可离线打开；
- 图表用 Canvas/SVG 手写，不依赖联网库；
- 数据用本地 JSON/Markdown；
- 适配桌面浏览器 + **手机适配（已确认必须做）**。

> 手机适配已确认必须做；深色/浅色切换待定。

### 1.6 代码讲解粒度

建议：

- 文件级：全部源文件都有“作用/必要性/技术/关键函数”；
- 算法级：核心算法文件逐段/逐行讲解；
- HAL/CubeMX：只讲“它负责什么”，不逐行讲库代码。

> 请确认“核心算法逐行 + 其它文件函数级”是否够。

---

## 2. 改造原则

1. **最小改动**：先解决通信/标定/理解问题，不做无必要的大重构。
2. **分层隔离**：主工程保持干净；调试/标定放到 Test_Project 和上位机“调试中心”。
3. **参数集中**：`config.h` / `config.py` 仍是唯一调参入口；另建“参数登记表”做索引。
4. **可回退**：每个阶段独立，出问题可回到上一版。
5. **教学优先**：每个算法都有“为什么/是什么/怎么调/怎么验证”。
6. **离线可用**：教学网站不依赖网络。

---

## 3. 交付物总览

| 交付物 | 形式 | 作用 |
|---|---|---|
| 上位机改造 | PySide6 代码 | 删手动页 PID；保留 PID 调参；新增调试中心 |
| 调试工程 | Test_Project 扩展 | 算法/标定命令，直接观察参数效果 |
| 参数手册 | Markdown + 网站 | 每个参数的范围/影响/测量方法 |
| 教学手册 | Markdown + SVG + 思维导图 | 从零基础讲懂整个工程 |
| 可视化网站 | 静态 HTML/CSS/JS | 架构/数据流/代码地图/参数/标定/PID 可视化 |
| 代码地图 | Markdown + 网站 | 每个文件的作用/必要性/技术/关键函数 |
| 标定与实验手册 | Markdown | CPR/轮径/几何/最小驱动/加速度/旋转/PID/路线 |

---

## 4. 详细大纲

### 4.1 上位机改造

#### 4.1.1 手动遥控页（删除 PID 直接操控）

保留：

- 虚拟摇杆；
- WASD 键盘；
- 速度限幅 vx/vy/wz；
- 原地左/右转 45°/90°；
- 急刹停 / 缓停 / 全停；
- 连接状态、链路诊断入口。

删除：

- “PID精准停”分组（距离输入 + 开始精准停按钮）。

结果：

- 手动页只做“直接操控”，不出现 PID 字眼；
- 用户不会被“PID停”与“手动控制”混在一起困扰。

#### 4.1.2 PID调参页（保留并增强）

保留：

- 位置环 Kp/Ki/Kd；
- 最大线速度/角速度；
- 速度平滑（加速度限制）；
- 下发/读取参数。

新增（建议）：

- “PID测试”分组：输入测试距离（mm）+ “开始 PID 测试”按钮，发送 0x04；
- 说明文字：告诉用户“这是位置环测试，不是手动遥控”。

#### 4.1.3 新增“调试中心”Tab

建议包含以下卡片：

1. **链路诊断**
   - 连接状态、RX 字节数、最后收到数据时间；
   - “测试链路”按钮（心跳 + ACK）；
   - 原始 TX/RX 帧显示（可选）。

2. **编码器标定**
   - 实时显示四轮累计计数/20ms 计数；
   - 输入“实际行驶距离（mm）”；
   - 自动计算建议 CPR；
   - 显示当前 CPR 与建议值。

3. **旋转标定**
   - “左转90° / 右转90°”按钮；
   - 输入“实际转过的角度（°）”；
   - 自动计算建议 `CFG_ROTATE_MS_PER_90`；
   - 显示当前值与建议值。

4. **最小驱动测试**
   - 滑杆 0.05~1.00（归一化）；
   - 单轮 A/B/C/D 点动、四轮点动；
   - 记录“开始震动/开始平稳”的阈值。

5. **轮子方向测试**
   - A/B/C/D 四个按钮，正/反各点动一次；
   - 记录“实际方向是否符合预期”；
   - 生成“建议符号表”（+1/-1）。

6. **麦轮几何预览**
   - 输入 vx/vy/wz；
   - 实时显示四轮目标线速度；
   - 可修改轴距/轮距，观察四轮速度变化。

7. **速度平滑**
   - 线加速度/角加速度滑杆；
   - 下发 0x0E；
   - 说明“这不是速度 PID，是加速度限制”。

8. **参数总览**
   - 只读展示当前关键参数；
   - 可下发的参数提供“下发”按钮；
   - 标注哪些是编译期参数（需改 config.h 重编译）。

> 说明：调试中心的目标是“让你自己能看到、能改、能验证”，而不是只给结论。

---

### 4.2 调试工程（Test_Project 扩展）

把现有 `Test_Project\MecanumTest` 从“硬件测试”扩展为“算法/标定调试工程”。

新增 ASCII 命令（建议）：

| 命令 | 作用 | 输出/效果 |
|---|---|---|
| `mecanum <vx> <vy> <wz>` | 只做麦轮逆解算，不驱动 | 打印四轮目标线速度/归一化值 |
| `encraw` | 打印原始计数、20ms、电压、标志位 | 用于确认编码器数据 |
| `cpcal <mm>` | 输入实际行驶距离，计算建议 CPR | 打印当前 CPR、建议 CPR |
| `rotcal <deg>` | 发 90° 后输入实测角度，计算建议时间 | 打印建议 `CFG_ROTATE_MS_PER_90` |
| `min <0-1>` | 单轮/四轮最小驱动测试 | 观察震动/起步阈值 |
| `sign <0-3> <±1>` | 记录/应用单轮方向符号 | 打印四轮符号表 |
| `geo <wheelbase> <track>` | 输入轴距/轮距，预览四轮速度 | 打印几何解算结果 |
| `ramp <v0> <v1> <accel>` | 打印加速度平滑时间线 | 看到速度随时间变化 |
| `pidstep <kp> <ki> <kd> <target>` | PID 阶跃响应（可只打印，不驱动） | 看到超调/上升时间 |
| `link` | 心跳/链路测试 | 成功/失败提示 |

每个命令配一段说明：

- 调的是哪个模块；
- 参数范围；
- 怎么测；
- 调错会怎样；
- 如何验证。

---

### 4.3 参数手册（`参数手册.md`）

按以下分类整理：

1. **电源与通信**
   - 电池电压、稳压输出、蓝牙波特率、驱动模块波特率、调试波特率。
2. **机械与几何**
   - 轮径、轴距、轮距、轮子安装方向、辊轮方向。
3. **编码器**
   - PPR、倍频、CPR、零点、方向符号。
4. **运动学**
   - vx/vy/wz 定义、逆运动学公式、归一化基准。
5. **控制**
   - 位置 PID、速度平滑、最小驱动、软停减速、旋转时间。
6. **安全**
   - 最大速度/角速度、急停、超时、限幅。
7. **调试**
   - 链路、原始帧、日志、测试命令。

每个参数统一格式：

- 名称；
- 当前值；
- 单位；
- 合理范围；
- 影响什么；
- 调大会怎样/调小会怎样；
- 怎么测量；
- 推荐标定步骤；
- 风险/注意事项。

---

### 4.4 教学手册（`教学手册.md`）

建议目录：

1. **项目总览**
   - 小车由哪些部分组成；
   - 三条链路（控制/反馈/测试）；
   - 软件分层。
2. **基础知识**
   - 电压/电流/电源/共地；
   - PWM 与 H 桥（AT8236）；
   - 直流有刷电机与减速箱；
   - 霍尔编码器 A/B 相、PPR、倍频、CPR；
   - UART、波特率、TTL、蓝牙 SPP/BLE；
   - 二进制协议、帧头、长度、校验。
3. **麦克纳姆轮运动学**
   - 辊轮方向、X/O 布局；
   - vx/vy/wz 定义；
   - 逆运动学公式推导；
   - 正运动学；
   - 轮速归一化。
4. **控制理论**
   - 开环/闭环；
   - 速度环、位置环、串级；
   - PID 三项作用、积分饱和、微分噪声；
   - 采样周期与离散化；
   - 加速度限制/平滑；
   - 死区、最小驱动。
5. **工程架构**
   - STM32 文件分层；
   - PC 上位机分层；
   - 测试工程；
   - 数据流图。
6. **代码逐文件讲解**
   - 每个文件的作用、必要性、技术点、关键函数；
   - 核心算法逐段/逐行解释；
   - 文件之间的调用关系。
7. **调试与标定**
   - 工具准备；
   - 链路测试；
   - CPR 标定；
   - 轮径/轴距/轮距测量；
   - 轮子方向/符号；
   - 最小驱动/死区；
   - 加速度平滑；
   - 45°/90° 旋转标定；
   - 位置 PID 调参；
   - 固定路线标定；
   - 故障排查树。
8. **实验课**
   - 实验1：串口通信；
   - 实验2：单轮转动；
   - 实验3：编码器读数；
   - 实验4：四轮前进；
   - 实验5：横移/旋转；
   - 实验6：PID 位置停；
   - 实验7：正方形路线。
9. **术语表**
10. **附录：参数总表、协议表、引脚表**

每章统一结构：

- 现象/问题；
- 原理；
- 工程里对应的文件/函数；
- 代码片段；
- 实验/验证；
- 常见错误；
- 调参建议。

---

### 4.5 可视化网站（`visualization/`）

建议页面：

1. **首页/项目总览**
   - 一句话介绍；
   - 三条链路图；
   - 快速导航。
2. **系统架构与数据流**
   - 点击模块显示文件/函数/作用；
   - PC→蓝牙→STM32→驱动→电机的动画/高亮。
3. **代码地图**
   - 按层展示所有源文件；
   - 每个文件：作用、必要性、技术、关键函数、调用关系；
   - 可搜索/筛选。
4. **参数中心**
   - 搜索/筛选参数；
   - 当前值、单位、范围、影响、测量方法；
   - 标注“编译期/运行期/只读”。
5. **标定向导**
   - CPR 计算器；
   - 旋转时间计算器；
   - 最小驱动记录表；
   - PID 参数记录表；
   - 输入实测值 → 输出建议值。
6. **麦轮运动学可视化**
   - vx/vy/wz 滑杆；
   - 实时显示四轮速度/方向；
   - 可切换 X/O 布局；
   - 显示轴距/轮距影响。
7. **PID 模拟器**
   - Kp/Ki/Kd 滑杆；
   - 一阶/二阶对象；
   - 显示阶跃响应、超调、上升时间；
   - 帮助理解“为什么积分会饱和、微分会放大噪声”。
8. **协议实验室**
   - 选择指令、输入参数；
   - 自动生成 AA55 帧；
   - 输入十六进制帧，解析出 CMD/DATA/CHECK；
   - 显示校验和计算过程。
9. **故障排查**
   - 决策树：蓝牙无数据 → 接线/波特率/AT模式/端口；
   - 电机不转 → 电源/驱动/命令/最小驱动；
   - 编码器无数据 → 接线/CPR/极性；
   - 路线异常 → 定时器/速度/转向时间。
10. **教学手册在线阅读**
    - 章节导航；
    - 示意图/思维导图；
    - 代码高亮。

技术建议：

- 纯静态 HTML/CSS/JS；
- 无外部 CDN、无构建步骤；
- 图表用 Canvas/SVG；
- **算法内容特别标注**：所有算法模块/参数/公式用 `【算法】` 标签和独立页面重点展示；
- 数据用本地 JSON；
- 双击 `index.html` 即可离线打开；
- **手机适配：确认必须做**（响应式布局，手机浏览器可读可操作）。

---

### 4.6 工程整理（暂不执行，用户要求先不清除）

- **暂不删除**重复的 `MecanumCar\User\User\` 过期副本（用户要求先不清除）；
- **暂不清理** `PC_上位机\_*.py` 和根目录 `_*.py` 临时脚本（用户要求先不清除）；
- 统一 `Test/config.h` 与 `User/config.h` 的参数；
- 可选：让 `usart.c` 真正引用 `CFG_DRIVER_BAUD`/`CFG_DEBUG_BAUD`；
- 可选：给 `DemoWorker` 补 0x0D/0x0E 的演示处理；
- 可选：删除未使用的 `CFG_ROUTE_SIDE_MM`/`CFG_ROTATE_TOL_DEG`/`CFG_YAW_SIGN`，或真正使用它们。

---

## 5. 分阶段执行计划

| 阶段 | 内容 | 产出 |
|---|---|---|
| 阶段0 | 大纲审核（本次） | 本文件 + 你的确认/补充 |
| 阶段1 | 上位机删除手动页 PID、保留 PID 调参、新增调试中心骨架 | 新版上位机 |
| 阶段2 | Test_Project 扩展调试命令 + 参数手册 | 调试工程 + `参数手册.md` |
| 阶段3 | 教学手册 + SVG 示意图 + 思维导图 + 代码地图 | `教学手册.md`、`代码地图.md`、`diagrams/` |
| 阶段4 | 可视化网站 | `visualization/index.html` 等 |
| 阶段5 | 联调、验收、清理 | 最终工程 + 验收清单 |

---

## 6. 验收标准

1. 手动遥控页**没有任何 PID 控件**；PID 调参页仍可用；
2. 调试中心能完成：链路测试、编码器读数/CPR 标定、旋转标定、最小驱动、轮子方向、几何预览、加速度平滑、PID 测试；
3. 每个“非基础算法/参数”都有对应的调试入口和文字说明；
4. 教学手册能让你独立完成：接线检查、链路测试、CPR 标定、轮径/几何测量、最小驱动、加速度、旋转、PID、路线；
5. 可视化网站离线可打开，能看懂架构、数据流、参数、代码地图、运动学和 PID；
6. 源码仍保持中文注释，关键文件有“作用/必要性/技术/关键函数”说明。

---

## 7. 需要你确认的问题（请逐条回复或直接补充）

1. **PID 删除范围**：是否按方案 A（只删手动页“PID精准停”，PID 调参页保留并加“PID测试”）？
2. **非基础代码范围**：是否按 0.2 的 11 项？有没有要增加/排除的？
3. **调试形式**：是否接受“扩展 Test_Project + 上位机调试中心 + 参数手册”的组合？
4. **教学文本格式**：Markdown + SVG + 思维导图是否够？是否还要 PDF/DOCX？
5. **网站技术**：纯静态离线、无外部依赖，是否可以？是否需要手机适配/深色浅色切换？
6. **代码讲解粒度**：核心算法逐行/逐段 + 其它文件函数级，是否够？
7. **执行顺序**：是否按阶段1→2→3→4→5？还是先做教学手册/网站，再改代码？
8. **工程清理**：是否允许在阶段5删除重复 `User\User` 和临时 `_*.py`？
9. **实测配合**：参数手册需要你实际测量（轮径、轴距、轮距、CPR、最大轮速、旋转角等），你是否愿意按步骤测量并记录？
10. **网站语言**：是否需要中文 + 英文术语对照（例如“PWM/脉宽调制”）？

> 你确认/补充后，我再进入阶段1；在你确认前，我不会修改任何源文件。

---

## 8. 确认记录（2026-10-19）

| 事项 | 确认结果 |
|---|---|
| 网站手机适配 | ✅ 必须做 |
| 算法内容特别标注 | ✅ 必须做：用 `【算法】` 标签、独立章节/页面、公式与参数说明 |
| 工程清理（重复 User\User、临时 _*.py） | ⏸ 暂不执行，先保留 |
| 其余大纲 | ✅ 接受，按阶段执行 |

> 阶段1已开始：上位机手动页 PID 分组已移除，PID 测试已移到 PID 调参页，新增“调试中心”Tab。

---

## 9. 阶段2进度（2026-10-19）

- ✅ `Test_Project` 已扩展为“硬件测试 + 算法标定”工程；
- ✅ 新增 `debug_algo.c/h`（麦轮、CPR、旋转时间、加速度平滑）；
- ✅ 新增 `pid.c/h`（PID 阶跃仿真）；
- ✅ 新增命令：`mecanum/geo/cpcal/rot90/rotcal/min/sign/ramp/pidstep/link`；
- ✅ 已用 Keil AC6 编译通过（0错误0警告）；
- ✅ 已生成 `参数手册.md`；
- ⏸ 固件未烧录（等你需要时再烧录测试工程）。

---

## 10. 阶段3进度（2026-10-19）

- ✅ 已生成 `教学手册.md`（零基础原理、数据流、硬件、协议、算法、代码地图、参数、标定、排错、自测题）；
- ✅ 已嵌入 `diagrams/` 中的系统架构、数据流、麦轮、编码器、PID、协议、状态机示意图；
- ✅ 算法章节统一使用 `【算法】` 标记；
- ✅ 已明确列出待实车确认的 15 项假设，没有把假设写成结论；
- ✅ 已给出最小改动清单摘要，源代码与重复文件暂未改动；
- ✅ 阶段3已完成，教学手册与示意图可用于阅读和教学。

---

## 11. 阶段4进度（2026-10-19）

- ✅ 已生成 `visualization/index.html`、`style.css`、`app.js`；
- ✅ 已完成手机响应式布局、侧边导航、代码筛选、参数搜索、标定计算器、麦轮运动学、PID 模拟、协议组帧/解析、故障排查；
- ✅ 已将 `教学手册.md` 转换为 `visualization/manual.html`，支持在线目录和手机阅读；
- ✅ 已复制 SVG 到 `visualization/assets/`，离线双击可打开；
- ✅ 已用桌面与手机宽度做浏览器冒烟测试，无页面级横向溢出；
- ⏸ 下一步进入阶段5：实车联调、标定记录与最终验收（需要你配合上电测试）。

---

## 12. 2026-10-21 按键遥控与控制测试改造进度

- ✅ 手动遥控改为按键式：前进/后退/左移/右移，按住移动、松开停止；
- ✅ 保留 WASD；增加共用平移速度滑块；
- ✅ 增加任意角度旋转输入和 45°/90° 快捷按钮；
- ✅ 普通手动、固定路线、旋转不使用 PID；
- ✅ PID 只保留在“控制与测试”页，位置控制支持正负目标距离；
- ✅ 删除固件和测试工程中的缓起/缓停/加速度平滑；
- ✅ 新增参数调节页，参数说明数据 78 项；
- ✅ 根据 `车轮布局.jpg` 更新辊轮方向图；
- ✅ 主工程与测试工程编译通过，主工程已烧录；
- ✅ 本次修改详情见 `本次修改说明_2026-10-21.md`。
