Chen-long-bo/-/本次修改说明_2026-10-21.md

# 本次修改说明（2026-10-21）

> 项目：蓝牙遥控麦轮小车  
> 修改目标：按键遥控、控制与测试分离、参数集中说明、删除缓起缓停、保留 A 方案。  
> 本文记录本次实际修改、验证结果、使用方法和待实车确认项。

---

## 1. 修改总览

本次修改遵循以下原则：

1. 普通手动、固定路线、旋转不使用 PID；
2. PID 只保留在“控制与测试”页；
3. 普通手动、固定路线、旋转取消缓起/缓停；
4. 遥控改为按键式，按住移动，松开停止；
5. 保留 WASD；
6. 平移速度使用一个共用滑块；
7. 增加参数调节页；
8. 保留原方案 A：STM32 负责高层控制，驱动模块负责内部速度环；
9. 不进行全 STM32 PWM/编码器底层重构，只给出后续优化建议。

---

## 2. 上位机修改

### 2.1 手动遥控页

- 删除摇杆遥控；
- 增加前进、后退、左移、右移按键；
- 按键按住时持续发送速度，松开立即发送停止；
- 增加一个共用的“平移速度”滑块；
- 保留 WASD：
  - W：前进
  - S：后退
  - A：左移
  - D：右移
- 增加旋转角度输入：
  - 范围 `0.1°～360°`；
  - 步进 `1°`；
  - 提供左/右 45°、左/右 90° 快捷按钮；
- 增加左转/右转指定角度按钮；
- 删除缓停按钮和普通控制中的 PID；
- 空格键仍为急停。

### 2.2 控制与测试页

- 原 PID 测试页更名为“控制与测试”；
- 保留 Kp、Ki、Kd 参数；
- 支持正负目标距离：
  - 正数：前进；
  - 负数：后退；
- 只有点击本页“开始 PID 位置控制”时才使用 PID；
- 旋转仍为时间控制，不使用 PID；
- 显示目标位置、实际位置、位置误差；
- 曲线显示：
  - 四轮目标速度；
  - 四轮实际速度；
  - 目标位置；
  - 实际位置；
  - 位置误差；
- 实际位置和误差由 PC 根据 0x81 状态帧中的四轮编码器计数计算。

### 2.3 参数调节页

新增“参数调节”Tab，包含：

- 运行期参数快速修改：
  - Kp、Ki、Kd；
  - 最大线速度；
  - 最大角速度；
- 参数总表，当前共 **78 项**，每项包含：
  - 参数名；
  - 当前值；
  - 单位；
  - 编译期/运行期；
  - 来源文件；
  - 含义；
  - 调大影响；
  - 调小影响；
  - 测试/调参方法；
  - 推荐范围与风险；
- 参数搜索；
- 按类型筛选；
- 待确认假设列表。

参数说明数据位于：

`PC_上位机/parameter_guide.json`

---

## 3. STM32 固件修改

### 3.1 普通控制取消缓起缓停

已删除：

- `CFG_ACCEL_V`
- `CFG_ACCEL_W`
- `CFG_SOFT_BRAKE_DECEL`
- `MODE_BRAKE_SOFT`
- `RampToZero()`
- `RampToward()`
- 普通手动/路线模式中的速度斜坡；
- 0x03 缓停指令；
- 0x0E 设置加速度指令。

当前行为：

- 手动模式直接执行目标速度；
- 固定路线直接执行路线速度；
- 旋转保持时间控制；
- 停止立即发送零速度。

### 3.2 PID 只用于位置控制

- 仅保留 `MODE_POS_STOP`；
- 只有 0x04 位置控制指令会进入 PID；
- 0x08 只修改位置 PID 参数；
- 普通手动、固定路线、旋转不调用 PID。

### 3.3 串口参数

- USART1：`CFG_BLUETOOTH_BAUD = 9600`
- USART2：`CFG_DRIVER_BAUD = 115200`
- USART3：`CFG_DEBUG_BAUD = 115200`
- `usart.c` 已改为真正引用上述宏，不再硬编码 USART2/USART3。

### 3.4 Keil 编译配置

- 主工程编译器改为 `ARM Compiler V6.22`；
- 清理了主工程 `uvprojx` 的 BOM；
- 主工程和测试工程均已重新编译。

---

## 4. 实车轮布局修正

根据工作区 `车轮布局.jpg`：

| 轮子 | 位置 | 辊轮方向（俯视） |
|---|---|---|
| A | 左前 | `/` |
| B | 右前 | `\` |
| C | 左后 | `\` |
| D | 右后 | `/` |

已同步更新：

- `diagrams/mecanum_layout.svg`
- `visualization/assets/mecanum_layout.svg`
- 教学手册中的辊轮方向说明；
- 参数页的待确认假设。

注意：

> 图中的辊轮方向是机械安装方向；电机正方向、编码器方向、代码符号仍需单轮测试确认，不能仅凭图片直接断定。

---

## 5. 控制架构比较与优化建议

### 方案 A（当前采用）

```text
STM32：运动学 + 位置 PID（仅测试页） + 模式/路线/旋转
        ↓ $Car 目标速度
驱动模块：内部速度环 + PWM + H 桥
        ↓
四个电机
```

优点：

- 当前已经跑通；
- 改动风险低；
- 驱动模块负责底层速度环和功率驱动；
- 不会因为 STM32 底层重构影响现有接线。

缺点：

- 驱动模块内部速度环参数不透明；
- 串口 `$Car` 有一层延迟；
- 控制周期和底层细节受模块限制。

### 方案 B（后续可选）

```text
STM32：运动学 + 速度环 + 位置环 + PWM + 方向 + 编码器读取
驱动板：只作为 H 桥功率级
```

理论上方案 B 的精度潜力更高，原因是：

- 控制周期可控；
- 速度环/位置环参数透明；
- 可以直接获得编码器计数；
- 可以做更细的滤波、前馈和抗饱和。

但方案 B 需要确认：

- 驱动板是否支持外部 PWM/方向输入；
- 是否能绕过板载 MCU 的速度环；
- STM32 是否有足够定时器和引脚接四路编码器；
- 是否有电流限制和过流保护。

### 当前结论

> 现阶段保留方案 A；如果标定后位置重复精度仍不够，再评估方案 B。

优先优化：

1. CPR 标定；
2. 轮径、轴距、轮距测量；
3. 单轮方向和编码器方向；
4. 最小驱动；
5. 旋转时间标定；
6. PID 抗饱和和位置误差记录；
7. 增加通信超时自动停车。

---

## 6. 编译与验证结果

已完成：

- 上位机 Python 语法检查；
- 上位机离屏启动测试；
- 参数页加载 78 项参数；
- 演示模式连接、手动按键、PID 启动/停止测试；
- STM32 主工程编译：0 Error(s), 0 Warning(s)；
- 测试工程编译：0 Error(s), 0 Warning(s)；
- 主工程 ST-Link 烧录：Erase Done / Programming Done / Verify OK；
- 烧录后使用 `python -m pyocd commander -t cortex_m -c reset go` 让 MCU 退出停止状态并运行；
- COM7 实机链路测试：收到 0x81 状态帧和 0x82 曲线帧，电池约 12655 mV。

烧录文件：

`STM32_Project/CubeMX/MecanumCar/MDK-ARM/MecanumCar/MecanumCar.hex`

---

## 7. 使用步骤

1. 打开上位机；
2. 选择 `COM7`，波特率 `9600`；
3. 点击“连接”；
4. 手动页用按键或 WASD；
5. 松开按键即停止；
6. 旋转输入角度后点左转/右转；
7. 需要 PID 时，切换到“控制与测试”页；
8. 在参数页查看参数含义和测试方法；
9. 修改运行期参数后点击“下发运行期参数”；
10. 修改编译期参数后，必须用 Keil 重新编译并烧录。

---

## 8. 仍需实车确认

- A/B/C/D 轮实际位置；
- 辊轮方向与代码运动学符号是否一致；
- 电机正方向；
- 编码器方向和倍频；
- 实际 CPR；
- 实际轮径；
- 实际轴距/轮距；
- 最大稳定轮速；
- 最小稳定驱动；
- 旋转方向；
- 旋转时间与角度关系；
- PID 参数和到位精度；
- 电池容量、放电倍率和加速时压降；
- 驱动板是否支持方案 B 的直接 PWM/方向控制。
