Chen-long-bo/-/00_需求与条件核对.md

# 蓝牙遥控麦轮小车 — 需求与条件核对（已更新至第1轮确认）

> 状态：阶段1（上位机去手动PID、加调试中心）已完成；阶段2（Test_Project 算法/标定命令 + 参数手册）已完成，Keil AC6 编译 0错误0警告。下一步：阶段3 教学手册/代码地图/示意图。

## 一、本轮已确认的修改

| 项目 | 最终确认 |
|---|---|
| 驱动板 | **四路编码器电机驱动模块**（松甲智能模块：板载编码器读取、支持IIC/UART、自带闭环） |
| 上位机配色 | **优雅黑风格** |
| 稳压模块 | 3.3V / 5V / 12V **多路同时输出** |
| 底盘尺寸 | 暂未测量 → config.h / config.py 先放占位值，量好改一处即可 |
| 固定路线 | **正方形**（默认0.8m×0.8m，可改） |
| 蓝牙 | **SPP经典蓝牙**，波特率 **9600**（保持默认，无需改AT） |
| 开发环境 | Keil5(MDK) + CubeMX 已装（含F4支持包，按已装处理） |

## 二、驱动模块关键信息（从《四路编码器电机驱动模块开发手册v1.2》提取）

- 电源输入：**6~12V**；520电机建议输入12V。
- 电机接口：4个 PH2.0-6P：`M-、5V、A、B、GND、M+`。
- 默认安装约定：A=左前、B=右前、C=左后、D=右后；四轮都给正速度时，AC逆时针、BD顺时针，车前进。
- IIC 接口：`SCL、SDA、GND、NC`，设备地址 **0x51**。
- UART 接口：`5V、GND、RX、TX`。
- 总线接口：`S、+、-`（舵机用，本项目暂不用）。
- IIC 寄存器：
  - 0x00 读电池ADC
  - 0x01 读4个电机累计脉冲
  - 0x02 读4个电机20ms脉冲（速度反馈）
  - 0x03 设置电机类型（0=520）
  - 0x04 编码器极性
  - 0x05 开环PWM（-100~100）
  - 0x06 闭环速度（-100~100）
  - 0x07 累计脉冲清零
  - 0x08 写轮径/编码器线数/减速比
- UART 命令：
  - `$Car:%f,%f,%f,%f!` 四轮闭环速度（-1~1）
  - `$Car_Pwm:%f,%f,%f,%f!` 四轮开环PWM（-1~1）
  - `$MOTOR_4CH_READ:encoder_total!` 读累计脉冲
  - `$MOTOR_4CH_READ:encoder_20ms!` 读20ms脉冲
  - `$MOTOR_4CH_READ:battery!` 读电压
  - `$MOTOR_4CH_SET:0!` 设520电机类型
  - `$MOTOR_PARAM:%d,%d,%d!` 设轮径cm、编码器线数、减速比
  - `$MOTOR_4CH_SET_ENCODER_POLARITY:%hhu!` 编码器取反

## 三、编码器/电机换算（默认值，先写进 config，联调时校准）

- 11PPR × 减速比56 = 616 脉冲/输出转（单相）
- 4倍频后 = **2464 counts/输出转**（CPR）
- 轮径默认 80mm = 0.08m

## 四、还差这 4 件事，请确认

1. **STM32 与驱动模块之间用哪种连接？**
   - 我建议用 **UART**（3根线，最简单，调试方便）。但手册没写模块串口波特率，请你看看驱动板丝印或卖家资料，告诉我波特率（常见9600/115200）。
   - 如果查不到波特率，我就用 **IIC**（地址0x51），需要在SCL/SDA各接一个4.7kΩ上拉电阻到3.3V（或先用STM32内部上拉）。

2. **闭环由谁做？（决定PID怎么写）**
   - 我建议：**STM32 自己做“速度环+位置环”串级PID**，驱动模块只用“开环PWM + 读编码器”功能。这样你的“PID调参面板”能真正调速度环和位置环参数，也方便后面自动驾驶。
   - 如果你希望更简单，也可用模块自带速度闭环，STM32只做位置环（但模块内部速度PID参数你无法调）。
   - 默认按前者做，你确认一下即可。

3. **供电方式（安全相关）**
   - 驱动模块标称输入6~12V，你的3S满电12.6V**略超12V**。
   - 建议：电池 → 稳压模块12V输出 → 驱动模块电源口（更安全）；请告诉我稳压模块 **12V输出最大电流** 是否≥3A。
   - 如果你确认卖家说12.6V直供没问题，也可以电池直供。另请补一下电池 **mAh 和 C数**。

4. **电机6P插头是否已和驱动模块电机座顺序一致？**
   - 模块座顺序是 `M-、5V、A、B、GND、M+`。
   - 你的电机线色是 红M1-、白M2+、黑GND、蓝Vcc、绿A、黄B。
   - 如果电机带的是成品PH2.0-6P插头，直接插通常是对的；如果你要自己压线，我会按“模块丝印”给你逐根接线表。请告诉我：**直接插，还是需要逐根接线表？**（你的编码器支持3.3V/5V，模块给5V没问题。）

## 五、已确定“方便后续修改”的做法

- 所有可调参数集中：STM32端 `config.h`，上位机端 `config.py`，教程里会写明“改哪个文件、哪一行”。
- 蓝牙协议带帧头/指令/数据/校验，并**预留自动驾驶、避障、视觉的指令段**，后续不用大改。
- 上位机预留“自动驾驶 / 避障 / 视觉”三个空Tab，协议和UI都留好扩展口。

## 六、进度与下一步

- 第0步：资料核对 ✅
- 第1步：接线图 + 引脚分配 + 通信协议 v0.1 ✅
- 第2步：STM32 工程骨架 + CubeMX生成 + Keil编译 ✅（`STM32_Project/CubeMX/MecanumCar/`，0错误0警告，固件已生成）
- 第3步（当前卡点）：烧录到STM32并做“驱动模块串口+编码器读数”联调（烧录报 Erase Failed，等你确认开发板供电和SWD接线）
- 第4步：上位机骨架 + 黑色UI + 串口/蓝牙连接
- 第5步：手动遥控联调
- 第6步：PID面板/曲线/日志 + PID精准停
- 第7步：正方形固定路线
- 第8步：完整教程 + 预留自动驾驶/避障/视觉
