Chen-long-bo/-/01_接线图.md

# 01 接线图与接线表（v0.1）

> 本文件配合同目录 `接线图.svg` 使用。接线时先断开电源，接完检查再上电。

## 0. 安全第一（先读）

1. 所有设备的 **GND 必须共地**（电池负极、稳压模块、STM32、驱动模块、HC-04、USB转串口）。
2. 驱动模块 UART 口上的 **5V 引脚不要接**，只接 RX / TX / GND。
3. USB转串口模块的 3.3V/5V **不要接**（STM32 已由稳压5V供电，避免倒灌）。
4. 电机先不要装轮子，或用东西把车架起来，第一次上电先看能不能转、方向对不对。
5. 上电顺序建议：全部接好 → 开驱动模块开关 → 最后接电池/开稳压模块。

---

## 1. 总览

见 `接线图.svg`。共 6 个设备：

- 3S锂电池（12V）
- 稳压模块（3.3V/5V/12V 多路输出）
- 四路编码器电机驱动模块
- STM32F407VET6
- HC-04 蓝牙模块
- USB转串口（调试用）、ST-Link（下载用）

---

## 2. 电源接线

| 序号 | 从 | 到 | 说明 |
|---|---|---|---|
| P1 | 电池 + | 稳压模块 IN+ | 电池正极 |
| P2 | 电池 - | 稳压模块 IN- | 电池负极，也是系统GND |
| P3 | 稳压 12V+ | 驱动模块电源口 + | 驱动模块标称6~12V，用12V |
| P4 | 稳压 12V- | 驱动模块电源口 - | 共地 |
| P5 | 稳压 5V+ | STM32 5V 引脚 | 给开发板供电 |
| P6 | 稳压 5V- | STM32 GND | 共地 |
| P7 | STM32 3V3 | HC-04 3V3 | 蓝牙供电 |
| P8 | STM32 GND | HC-04 GND | 共地 |

> 驱动模块的 4 个电机座会自己给霍尔编码器供 5V，不需要额外给编码器接电源。

---

## 3. STM32 ↔ 驱动模块（UART 115200）

| 序号 | STM32 引脚 | 方向 | 驱动模块引脚 | 说明 |
|---|---|---|---|---|
| D1 | PA2 (USART2_TX) | → | RX | STM32发数据给驱动模块 |
| D2 | PA3 (USART2_RX) | ← | TX | STM32收驱动模块数据 |
| D3 | GND | ↔ | GND | 共地 |
| D4 | （不接） |  | 5V | **不要接** |

> 串口参数：`115200, 8, N, 1`。

---

## 4. STM32 ↔ HC-04 蓝牙（SPP 9600）

| 序号 | HC-04 引脚 | 方向 | STM32 引脚 | 说明 |
|---|---|---|---|---|
| B1 | 3V3 | ← | 3V3 | 蓝牙供电 |
| B2 | GND | ↔ | GND | 共地 |
| B3 | RXD | ← | PA9 (USART1_TX) | STM32发→蓝牙收 |
| B4 | TXD | → | PA10 (USART1_RX) | 蓝牙发→STM32收 |
| B5 | KEY | 悬空 | — | 本项目不用 |
| B6 | STA | 悬空 | — | 状态脚，可不接 |

> 串口参数：`9600, 8, N, 1`。电脑上用“经典蓝牙SPP”配对 HC-04（密码1234），配对后会出现一个 COM 口。

---

## 5. STM32 ↔ USB转串口（调试，可选但强烈建议）

| 序号 | STM32 引脚 | 方向 | USB转串口引脚 | 说明 |
|---|---|---|---|---|
| T1 | PB10 (USART3_TX) | → | RXD | 调试日志输出 |
| T2 | PB11 (USART3_RX) | ← | TXD | 调试指令输入 |
| T3 | GND | ↔ | GND | 共地 |
| T4 | （不接） |  | 3V3/5V | **不要接** |

> 串口参数：`115200, 8, N, 1`。

---

## 6. ST-Link（下载程序）

| ST-Link 引脚 | STM32 引脚 |
|---|---|
| SWDIO | PA13 |
| SWCLK | PA14 |
| GND | GND |
| 3.3V | 3V3（可选） |

---

## 7. 电机插头

| 驱动模块电机座 | 车轮位置 |
|---|---|
| A | 左前 |
| B | 右前 |
| C | 左后 |
| D | 右后 |

- 你的电机是**成品 PH2.0-6P 插头，直接插**即可。
- 模块座顺序为 `M-、5V、A、B、GND、M+`。
- 手册默认：四轮都给正速度时，A/C 逆时针、B/D 顺时针，车向前走。

---

## 8. 上电前检查清单

- [ ] 电池未接/开关关闭
- [ ] 所有 GND 共地
- [ ] 驱动模块 UART 的 5V 未接
- [ ] USB转串口 3.3V/5V 未接
- [ ] 电机插头插紧，轮子已架空
- [ ] HC-04 供电为 3.3V，不是 12V
- [ ] ST-Link / USB转串口已接电脑
