Chen-long-bo/-/02_引脚分配表.md

# 02 引脚分配表（STM32F407VET6，v0.1）

> 后续代码若调整引脚，只改本表 + CubeMX 配置 + `config.h` 顶部引脚宏。

| STM32引脚 | 功能 | 外设 | 方向 | 接到哪里 | 备注 |
|---|---|---|---|---|---|
| PA9 | USART1_TX | USART1 | 输出 | HC-04 RXD | 蓝牙 9600 |
| PA10 | USART1_RX | USART1 | 输入 | HC-04 TXD | 蓝牙 9600 |
| PA2 | USART2_TX | USART2 | 输出 | 驱动模块 RX | 115200 |
| PA3 | USART2_RX | USART2 | 输入 | 驱动模块 TX | 115200 |
| PB10 | USART3_TX | USART3 | 输出 | USB转串口 RXD | 调试 115200 |
| PB11 | USART3_RX | USART3 | 输入 | USB转串口 TXD | 调试 115200 |
| PA13 | SWDIO | SYS_SWD | 双向 | ST-Link SWDIO | 下载调试 |
| PA14 | SWCLK | SYS_SWD | 输入 | ST-Link SWCLK | 下载调试 |
| 5V | 电源输入 | — | 输入 | 稳压 5V+ | 给开发板供电 |
| 3V3 | 电源输出 | — | 输出 | HC-04 3V3 | 给蓝牙供电 |
| GND | 地 | — | — | 所有GND | 必须共地 |

> 本项目**不使用** STM32 的 PWM 和定时器编码器模式，因为驱动模块自己读编码器、自己出PWM；STM32 通过串口给驱动模块发“四轮目标速度”，并读回编码器计数。

## CubeMX 外设配置要点

| 外设 | 参数 |
|---|---|
| RCC | HSE 8MHz 晶振，PLL 配到 168MHz |
| SYS | Serial Wire (SWD)，PA13/PA14 |
| USART1 | 9600, 8N1, TX/RX 使能 |
| USART2 | 115200, 8N1, TX/RX 使能 |
| USART3 | 115200, 8N1, TX/RX 使能 |
| 其它 | 先不用 TIM/PWM/ADC |
