Chen-long-bo/-/STM32_Project/已生成工程说明.md

# 已生成工程说明（第2步成果，已自动生成+编译通过）

> 我已用你工作区里的 STM32CubeMX 和 Keil 快捷方式，自动生成了 HAL 工程并编译通过。

## 一、生成结果

| 项目 | 路径 |
|---|---|
| CubeMX工程（.ioc） | `STM32_Project\CubeMX\MecanumCar\MecanumCar.ioc` |
| Keil工程（.uvprojx） | `STM32_Project\CubeMX\MecanumCar\MDK-ARM\MecanumCar.uvprojx` |
| 编译输出固件 | `STM32_Project\CubeMX\MecanumCar\MDK-ARM\MecanumCar\MecanumCar.hex` |
| 用户代码 | `STM32_Project\CubeMX\MecanumCar\User\` |

## 二、编译结果

- 编译器：Keil MDK V5.06（ARMCC V5）
- **0 Error(s), 0 Warning(s)**
- 程序大小：Code=12010, RO-data=738, RW-data=80, ZI-data=2256

## 三、已完成的自动操作

1. 用 CubeMX 生成 STM32F407VET6 工程：
   - 时钟：HSE 8MHz 晶振 → PLL → **168MHz**
   - SWD：PA13/PA14
   - USART1：PA9/PA10，9600（蓝牙）
   - USART2：PA2/PA3，115200（驱动模块）
   - USART3：PB10/PB11，115200（调试）
   - USART1/USART2 已开启接收中断
2. 把 `User` 文件夹加入 Keil 工程，并配置 include 路径。
3. 修改 `main.c`：加入 `User_Init()` 和 `User_Loop()`。
4. Keil 命令行编译，得到 `MecanumCar.hex`。

## 四、烧录状态（需要你确认电源）

我尝试用 ST-Link 烧录，结果：**Erase Failed! Flash Download failed - "Cortex-M4"**。

请按下面检查后再让我重试：

1. STM32 开发板是否已供电？（稳压模块5V → 开发板5V，开发板电源灯应亮）
2. ST-Link 接线：
   - SWDIO → PA13
   - SWCLK → PA14
   - GND → GND
   - 3V3 → 3V3（建议接上，供目标电压检测）
3. ST-Link USB 已插电脑（我已检测到 `STM32 STLink` 设备）
4. 板子上没有按着复位键

## 五、你也可以自己在 Keil 里烧录

1. 双击打开 `STM32_Project\CubeMX\MecanumCar\MDK-ARM\MecanumCar.uvprojx`
2. 点 `Flash → Download (F8)`

## 六、上电自检（烧录成功后）

用串口助手打开 **COM5，115200**，复位开发板，应看到：
`Mecanum Car boot v0.1`
