Chen-long-bo/-/分享文件/使用说明.txt

麦轮实验室分享文件说明

1. 只想发教学手册：
   直接发送“教学手册_单文件版.html”。
   这个文件已经把背景、样式、7 张示意图全部内嵌，单独一个文件即可打开。

2. 想分享整个可视化网站：
   直接发送“麦轮实验室_单文件版.html”。
   这个文件已经把网站样式、交互脚本、示意图和教学手册全部内嵌。

3. 想保留可继续修改的完整工程：
   发送“麦轮实验室_离线分享包.zip”，对方先完整解压，再双击 index.html。
   不要直接在 ZIP 预览窗口里双击 index.html，否则可能只打开 HTML，丢失 style.css、app.js 和 assets，页面就会没有背景和 UI。

4. 原来的 manual.html 不是单文件版：
   它依赖同目录的 style.css 和 assets/ 文件夹，微信只转发一个 manual.html 时会丢失样式和图片。
