Chen-long-bo/-/visualization/portable/麦轮实验室_离线版/打开说明.txt

麦轮实验室 · 离线分享包
================================

为什么直接打开 ZIP 里的 index.html 会没有背景和 UI？
- ZIP 预览窗口可能只解压了 index.html；
- 浏览器找不到同目录的 style.css、app.js 和 assets/，于是只剩裸 HTML。

正确打开方式（推荐）
--------------------
1. 先把整个压缩包解压到普通文件夹；
2. 双击文件夹里的 index.html；
3. 不要直接在 ZIP 预览窗口里双击。

最省事的分享方式
----------------
直接发送“麦轮实验室_单文件版.html”。
这个文件已经内嵌 CSS、JS、SVG 和教学手册，单独一个文件即可打开。

文件说明
--------
- index.html                  多文件版入口
- manual.html                 多文件版教学手册
- 麦轮实验室_单文件版.html    推荐分享的单文件版
- 教学手册_单文件版.html      独立单文件教学手册
- style.css / app.js / assets 多文件版依赖，不能单独删除
- 参数手册.md / Keil使用导航.md / 教学手册.md 原始文档

注意
----
- 网站不需要联网，也不会上传数据；
- 网站不连接真实串口，是教学、标定计算和协议演示工具；
- 如果浏览器仍显示旧样式，按 Ctrl+F5 强制刷新。
