Chen-long-bo/-/_wheel_crops/A_tl.png

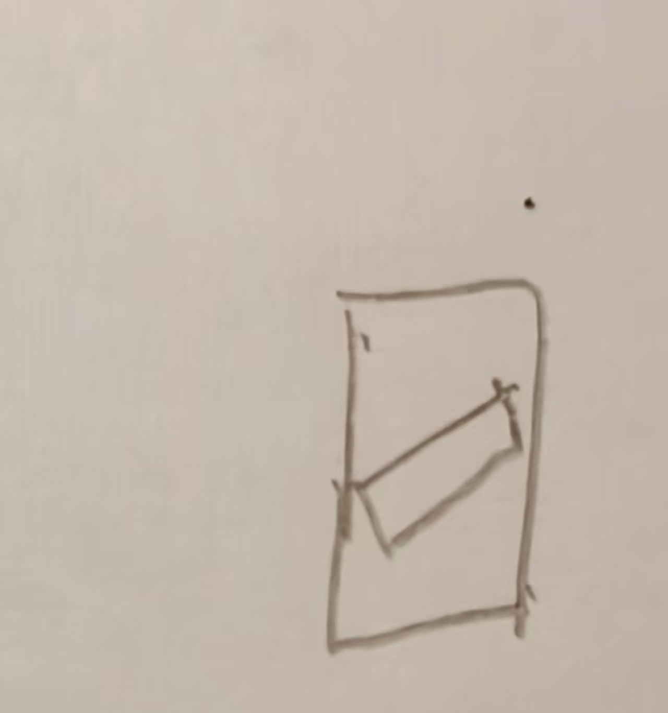
_wheel_crops/A_tl.png
