Chen-long-bo/-/_wheel_crops/B_tr.png

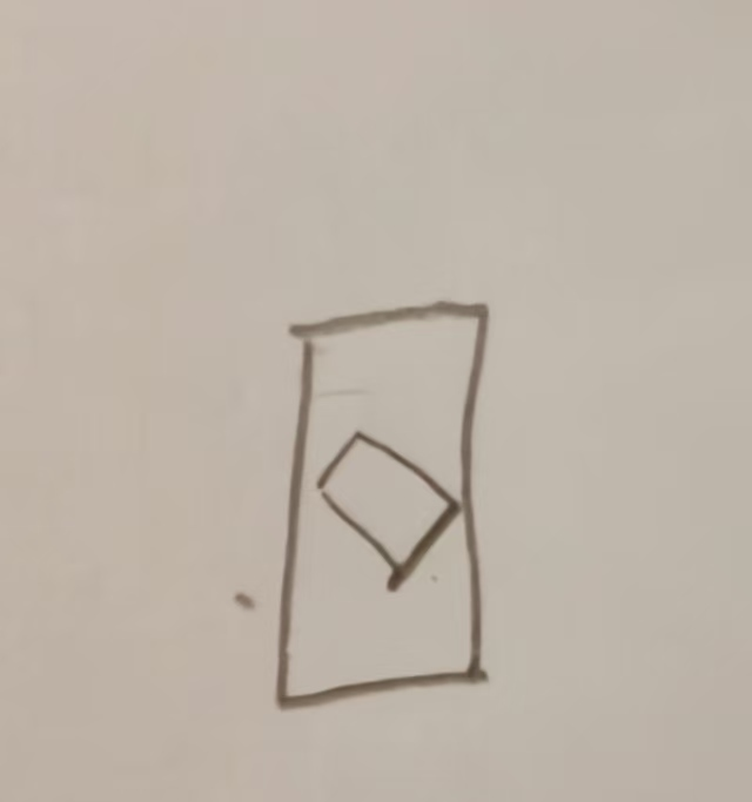
_wheel_crops/B_tr.png
