Chen-long-bo/-/_wheel_crops/C_bl.png

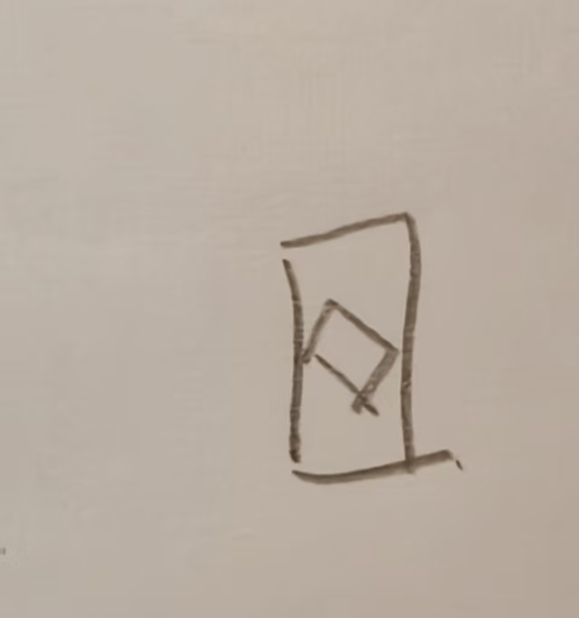
_wheel_crops/C_bl.png
