Chen-long-bo/-/_wheel_crops/D_br.png

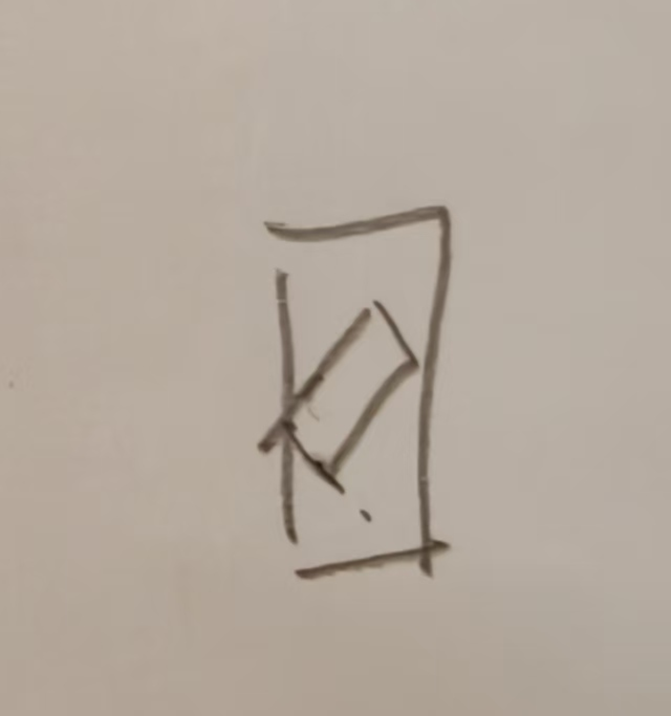
_wheel_crops/D_br.png
