Chen-long-bo/-/visualization/screenshots/desktop-final-2.png

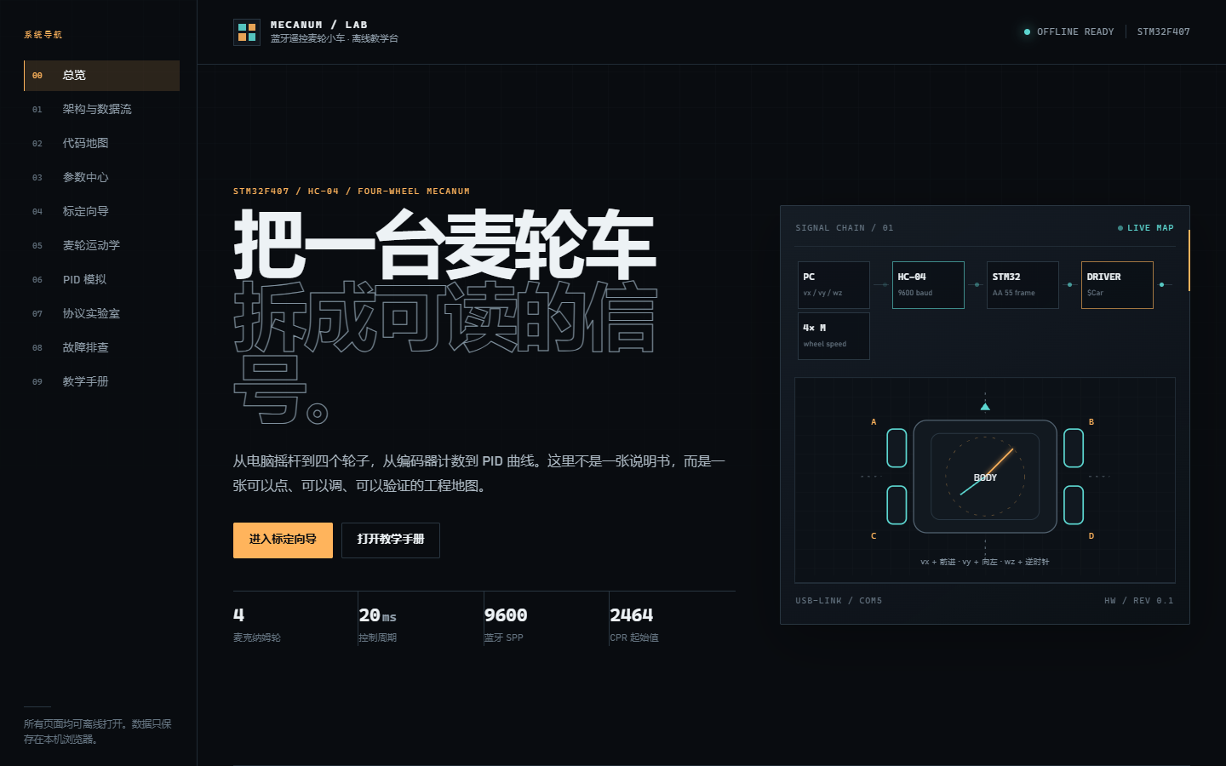
visualization/screenshots/desktop-final-2.png
