Chen-long-bo/-/visualization/screenshots/desktop-final-3.png

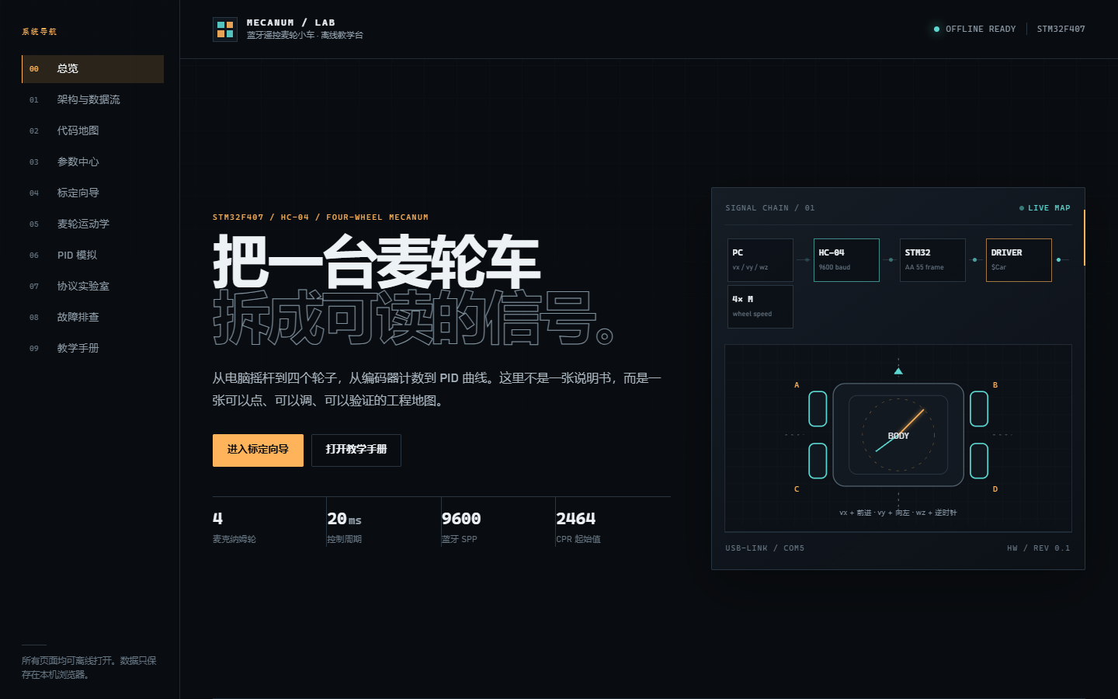
visualization/screenshots/desktop-final-3.png
