Chen-long-bo/-/visualization/screenshots/desktop-final.png

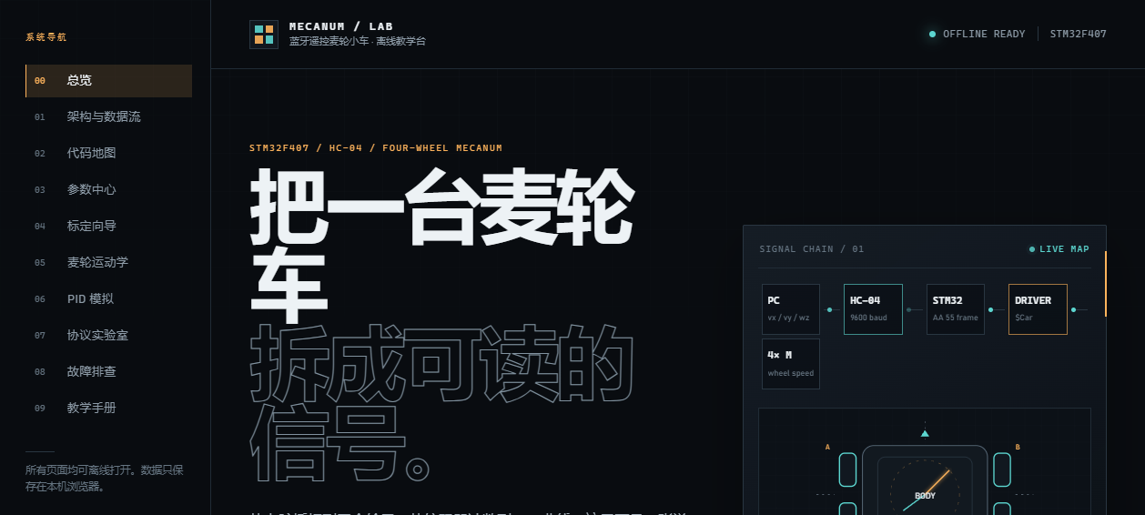
visualization/screenshots/desktop-final.png
