Chen-long-bo/-/visualization/screenshots/desktop-top.png

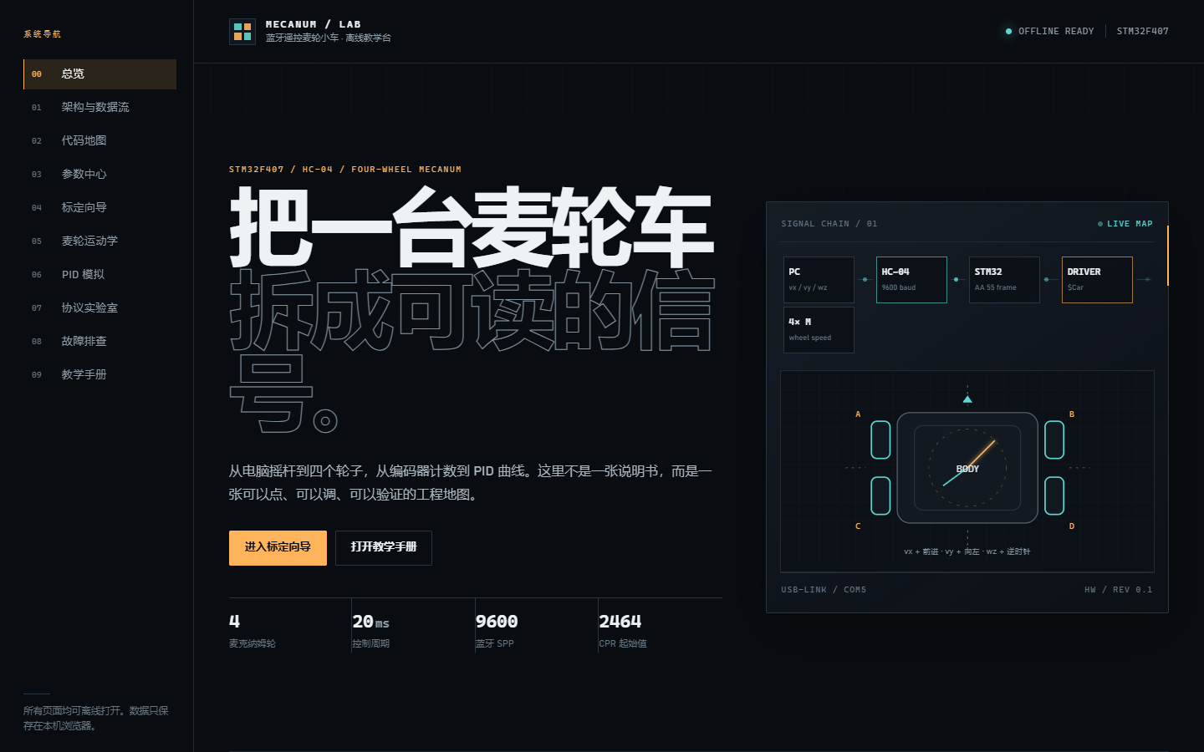
visualization/screenshots/desktop-top.png
