Chen-long-bo/-/visualization/screenshots/desktop.png

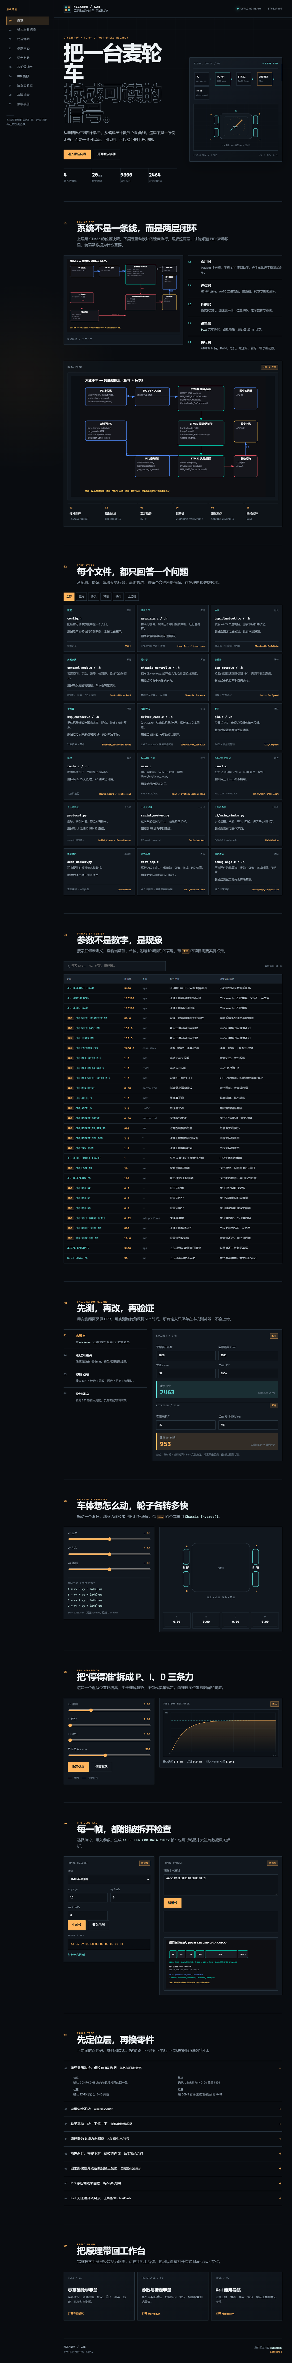
visualization/screenshots/desktop.png
