Chen-long-bo/-/visualization/screenshots/mobile-320.png

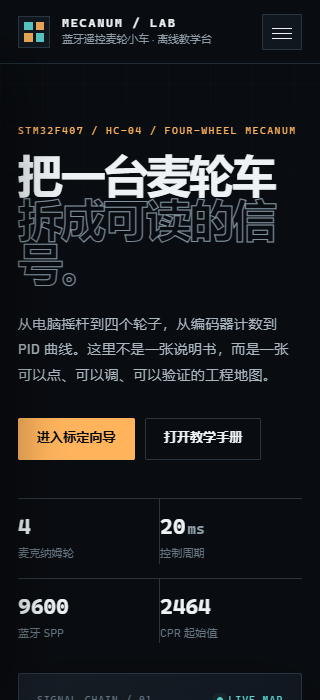
visualization/screenshots/mobile-320.png
