Chen-long-bo/-/visualization/screenshots/mobile-final-2.png

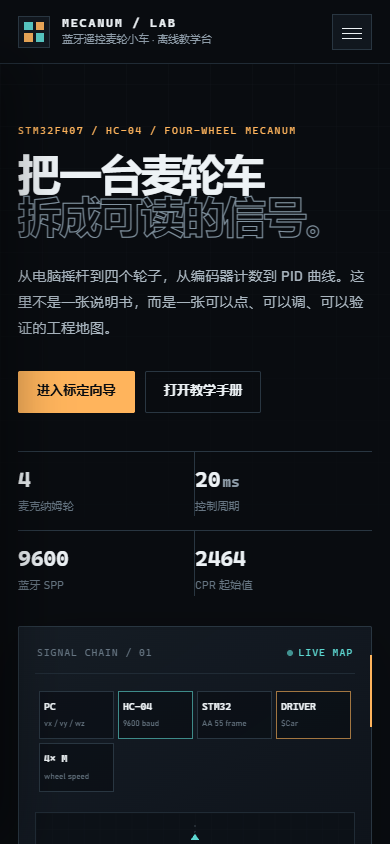
visualization/screenshots/mobile-final-2.png
