Chen-long-bo/-/visualization/screenshots/mobile-final-3.png

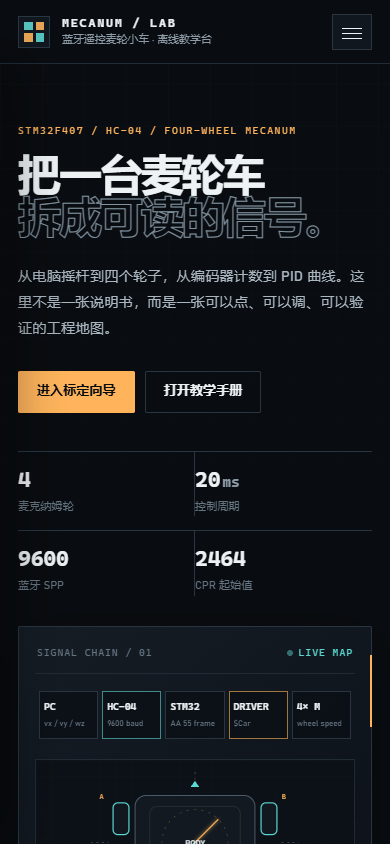
visualization/screenshots/mobile-final-3.png
