Chen-long-bo/-/visualization/screenshots/mobile-full.png

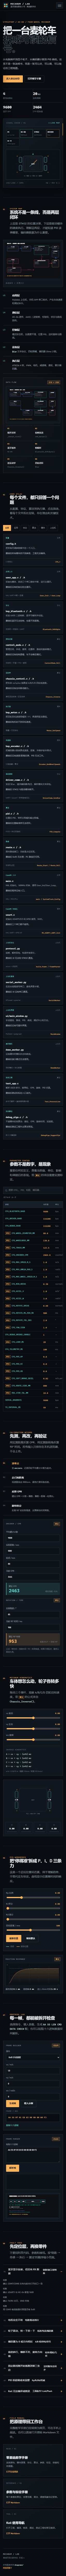
visualization/screenshots/mobile-full.png
