Chen-long-bo/-/visualization/screenshots/mobile-kinematics-2.png

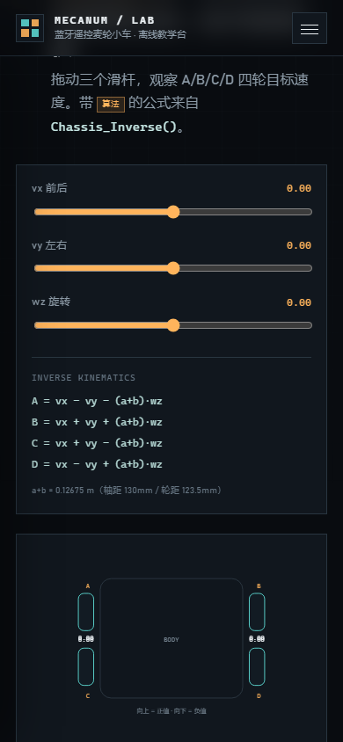
visualization/screenshots/mobile-kinematics-2.png
