Chen-long-bo/-/visualization/screenshots/mobile-kinematics.png

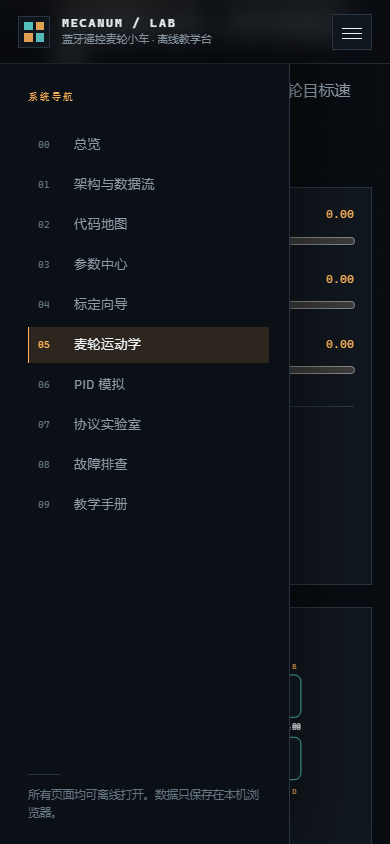
visualization/screenshots/mobile-kinematics.png
