Chen-long-bo/-/visualization/screenshots/mobile-menu.png

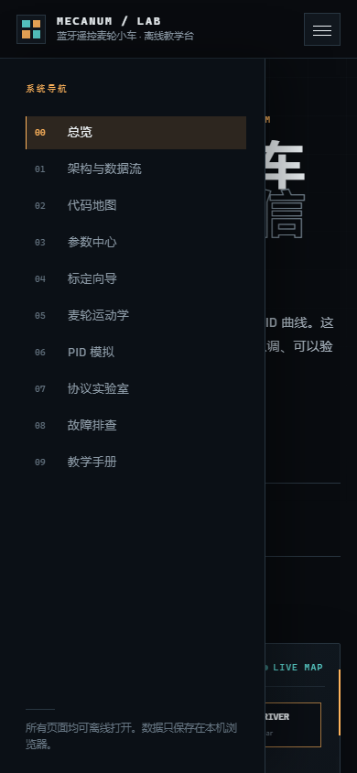
visualization/screenshots/mobile-menu.png
