Chen-long-bo/-/visualization/screenshots/mobile-protocol-2.png

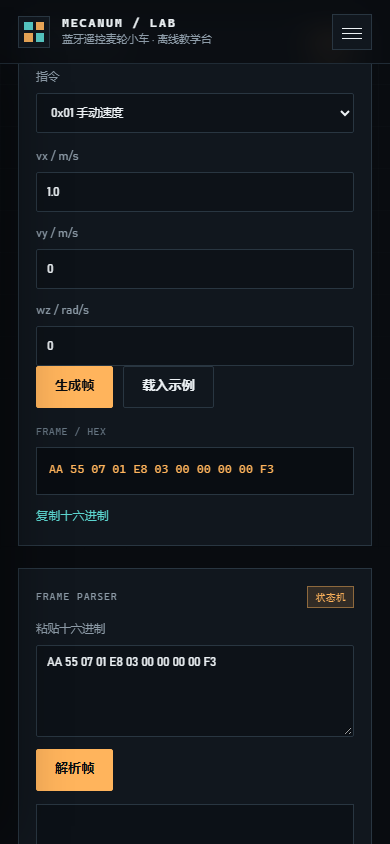
visualization/screenshots/mobile-protocol-2.png
