Chen-long-bo/-/visualization/screenshots/mobile-protocol.png

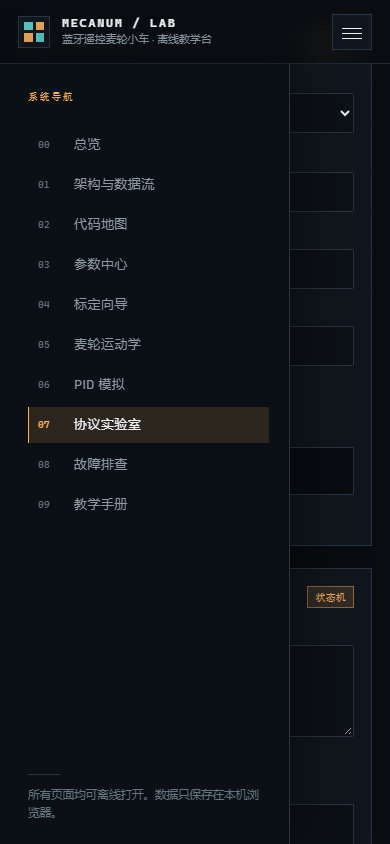
visualization/screenshots/mobile-protocol.png
