Chen-long-bo/-/visualization/screenshots/mobile-top.png

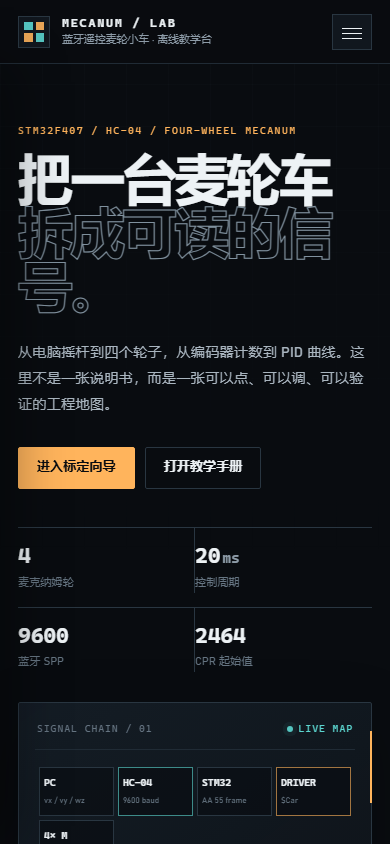
visualization/screenshots/mobile-top.png
