Chen-long-bo/-/小车底板.3mf

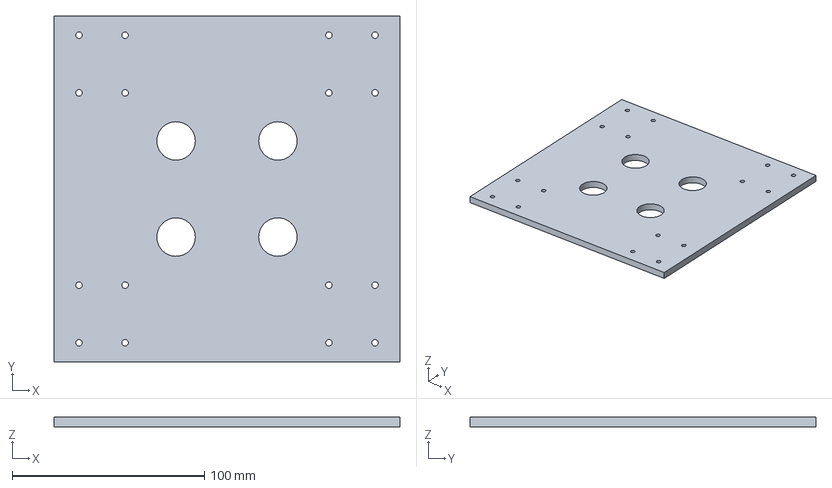
[picture p21: CAD file, 2026-10-18]
小车底板.3mf
180.0 x 180.0 x 5.00 mm
