Chen-long-bo/-/(list of files, cad)

Other CAD files:
小车底板.STL
