Chen-long-bo/-/visualization/screenshots/manual-320.png

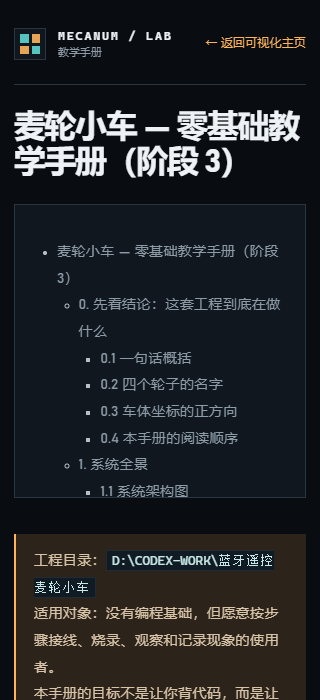
visualization/screenshots/manual-320.png
