Chen-long-bo/-/visualization/screenshots/manual-mobile.png

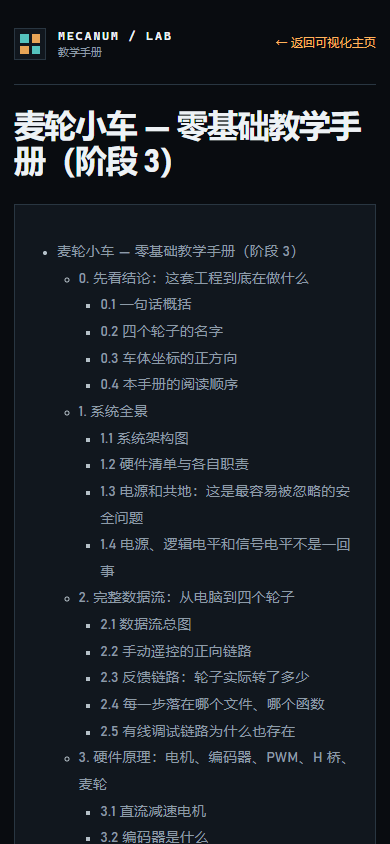
visualization/screenshots/manual-mobile.png
