Chen-long-bo/-/visualization/screenshots/single-file-main-manual-overlay.png

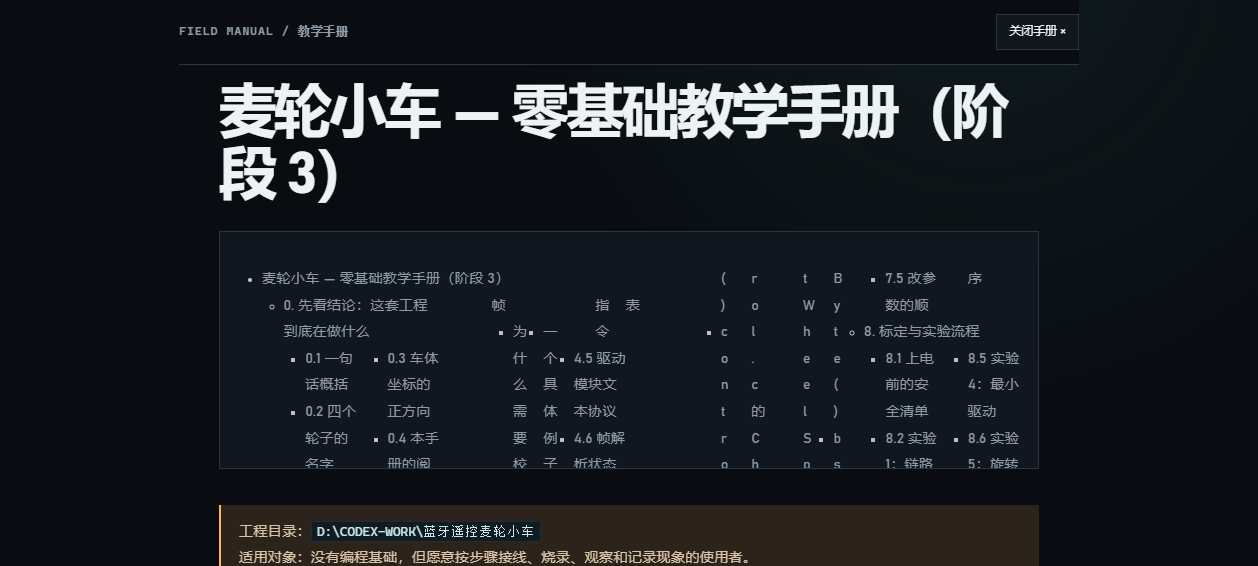
visualization/screenshots/single-file-main-manual-overlay.png
