Chen-long-bo/-/visualization/screenshots/single-file-manual-fixed.png

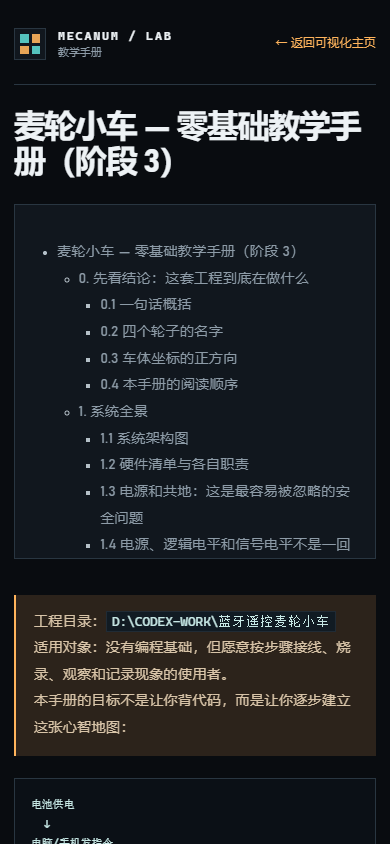
visualization/screenshots/single-file-manual-fixed.png
