Chen-long-bo/-/visualization/screenshots/single-file-manual.png

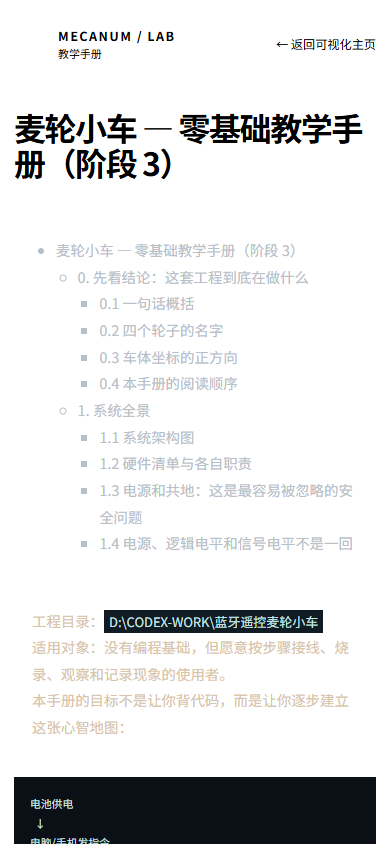
visualization/screenshots/single-file-manual.png
