Chen-long-bo/-/visualization/screenshots/mobile-calibration-2.png

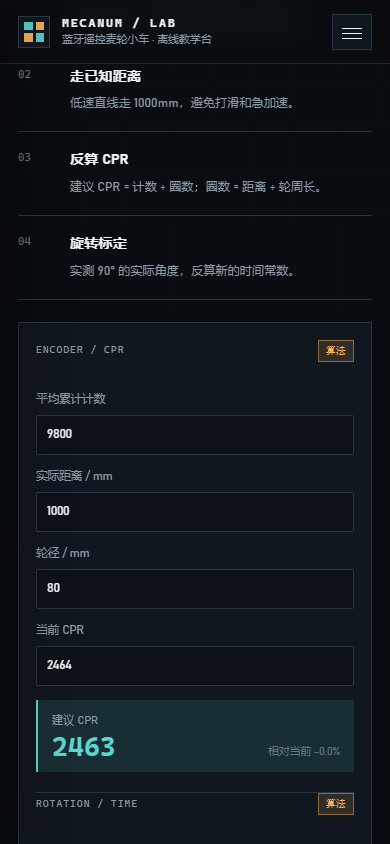
visualization/screenshots/mobile-calibration-2.png
