Chen-long-bo/-/STM32_Project/CubeMX/MecanumCar/User/config.h

#ifndef __CONFIG_H
#define __CONFIG_H

/* ============================================================
 * 本文件是唯一编译期调参入口。
 * 当前版本已删除缓起/缓停/加速度平滑参数。
 * ============================================================ */

/* 版本 */
#define CFG_FW_VER_MAJOR        0        /* 主版本号 */
#define CFG_FW_VER_MINOR        1        /* 次版本号 */

/* 串口波特率 */
#define CFG_BLUETOOTH_BAUD      9600     /* HC-04蓝牙 */
#define CFG_DRIVER_BAUD         115200   /* 四路驱动模块 */
#define CFG_DEBUG_BAUD          115200   /* USB转串口调试 */

/* 车轮与底盘尺寸（量好后改这里，单位毫米） */
#define CFG_WHEEL_DIAMETER_MM   80.0f    /* 轮径 */
#define CFG_WHEELBASE_MM        130.0f   /* 前后轴距 */
#define CFG_TRACK_MM            123.5f   /* 左右轮距 */

/* 编码器：4倍频后每转计数 = 11PPR * 56减速比 * 4 */
#define CFG_ENCODER_CPR         2464.0f

/* 运动限幅 */
#define CFG_MAX_SPEED_M_S       1.0f     /* 最大平移速度 m/s */
#define CFG_MAX_OMEGA_RAD_S     1.0f     /* 最大旋转角速度 rad/s */
#define CFG_MAX_WHEEL_SPEED_M_S 1.0f     /* 轮子线速度上限，用于归一化到 $Car 的 -1~1 */
#define CFG_MIN_DRIVE           0.30f    /* 最小有效驱动速度（归一化），低于此值电机易震动 */

/* 原地旋转：时间控制，不使用PID */
#define CFG_ROTATE_DRIVE        0.60f    /* 原地旋转时的轮速（归一化，>=最小驱动） */
#define CFG_ROTATE_MS_PER_90    900      /* 原地转90度所需时间（毫秒），按实车调整 */
#define CFG_ROTATE_TOL_DEG      2.0f     /* 预留：旋转到位误差（度），当前未使用 */
#define CFG_YAW_SIGN            1.0f     /* 预留：偏航角符号，当前未使用 */
#define CFG_DEBUG_BRIDGE_ENABLE 1        /* 1=协议帧同时从调试串口输出，方便有线联调 */

/* 控制周期 */
#define CFG_LOOP_MS             20       /* 主控制周期 ms */
#define CFG_TELEMETRY_MS        100      /* 状态上报周期 ms */

/* 位置环PID参数（速度环由驱动模块 $Car 内部完成） */
#define CFG_POS_KP              0.8f     /* 位置环比例 */
#define CFG_POS_KI              0.0f     /* 位置环积分 */
#define CFG_POS_KD              0.0f     /* 位置环微分 */

/* 固定路线：正方形边长 mm */
#define CFG_ROUTE_SIDE_MM       800

#endif /* __CONFIG_H */
