Chen-long-bo/-/PC_上位机/_bt_com7.py

import serial, time
import protocol
port="COM7"
print("== try", port)
try:
    s=serial.Serial(port,9600,timeout=0.5,write_timeout=1.0)
except Exception as e:
    print("OPEN FAIL", repr(e)); raise SystemExit
print("OPEN OK")
s.reset_input_buffer()
try:
    s.write(protocol.cmd_heartbeat())
    print("wrote")
except Exception as e:
    print("WRITE FAIL", repr(e))
time.sleep(1.0)
d=s.read(4096)
print("RX", len(d), "bytes")
print("ACK:", bytes([0xAA,0x55,0x03,0x83,0x0A,0x00,0x90]) in d)
s.close()
