Chen-long-bo/-/Test_Project/MecanumTest/Test/config.h

#ifndef __CONFIG_H
#define __CONFIG_H

/* 测试工程参数（只用于硬件测试） */
#define CFG_WHEEL_DIAMETER_MM   80.0f    /* 轮径 mm */
#define CFG_WHEELBASE_MM        130.0f   /* 轴距 mm（占位） */
#define CFG_TRACK_MM            123.5f   /* 轮距 mm（占位） */
#define CFG_ENCODER_CPR         2464.0f  /* 4倍频每转计数 */
#define CFG_MAX_WHEEL_SPEED_M_S 1.0f     /* $Car 归一化基准 m/s */

#endif
