Chen-long-bo/-/(commit log)

2026-10-19 新增调试工程，和可视化工程解释
    删掉上位机直接操控的pid算法，单列pid调试页，加调试工程，和所有工程解释，添加可视化工程解释网页
2026-10-21 删掉缓慢启停，改为按键操控，优化参数页
    按键遥控、PID 分离、参数页、缓起缓停删除和烧录结果
